erebus-labs/sense_platform/Documents/DIAGRAMS/stacking i2c image.jpg

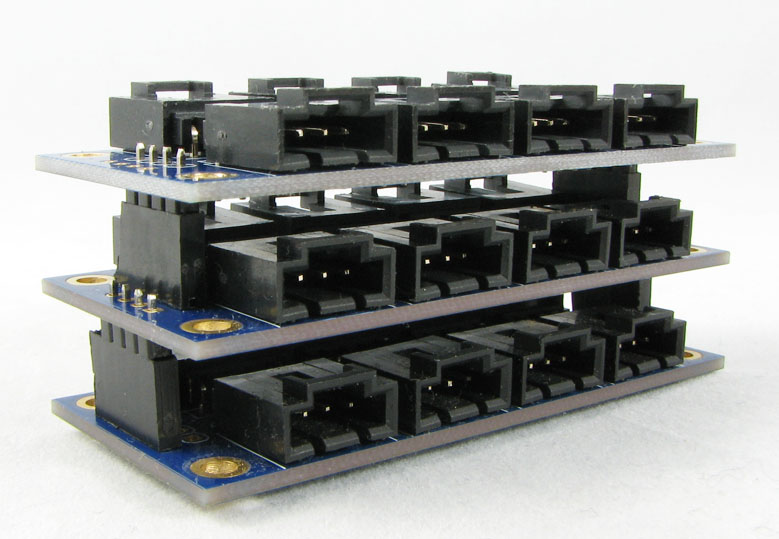
Documents/DIAGRAMS/stacking i2c image.jpg
