erebus-labs/sense_platform/Documents/Requirements Specification.docx

Electrical and Computer Engineering Capstone Requirements/Specifications

Version 1.1

2/22/2015

Erebus Labs

Open Sensor Platform

Submitted By:

Colten Nye

Steve Peirce

Golriz Sedaghat

Supervisor:

Dr. Lisa Zurk

Sponsors:

Dr. Mike Borowczak

Dr. Andrea Burrows

Table of Contents

Introduction

Our goal is to develop and prototype an inexpensive and accessible solution to collect data points of one or more sense-able physical attributes over an arbitrary duration of time. For more information, please refer to the project proposal document.

Requirements

# 1. Function

## 1.1. Configuration

### 1.1.1. Must: Be able to configure device operating parameters…

#### 1.1.1.1. Must: … using low level capabilities (e.g. write a script).

#### 1.1.1.2. Should: … using mid-level capabilities (e.g. using command line functions).

#### 1.1.1.3. May: … using high level capabilities (e.g. using a GUI).

### 1.1.2. Should: Be able to reconfigure parameters in the field (e.g. using a portable computer with USB port.

### 1.1.3. Parameters that may be configured:

#### 1.1.3.1. For each sensor:

#### 1.1.3.1.1. Must: Polling frequency for each sensor.

#### 1.1.3.1.2. Must: Interrupt condition (to take a measurement) for each sensor.

#### 1.1.3.1.3. Should: Out-of-range threshold(s) for each sensor.

#### 1.1.3.2. For the system:

#### 1.1.3.2.1. Should: Low power indicator threshold.

#### 1.1.3.2.2. Should: Low storage indicator threshold.

#### 1.1.3.2.3. Should: Continuous recording Vs. End when out of memory. (keep latest data vs. keep first data)

#### 1.1.3.2.4. May: Conditional data logging, e.g.:

##### 1.1.3.2.4.1. Only log within a time window.

##### 1.1.3.2.4.1.1. Only log within repeating time windows.

##### 1.1.3.2.4.2. Log conditional on a sensor value.

##### 1.1.3.2.4.3. Log conditional on the power level.

## 1.2. Feedback

### 1.2.1. Device must be able to give feedback for certain conditions:

#### 1.2.1.1. Must: Sensor read error.

#### 1.2.1.2. Must: IO busy/idle (do not remove storage device).

#### 1.2.1.3. Should: Low power.

#### 1.2.1.4. Should: Low storage.

#### 1.2.1.5. Should: Sensor value out of threshold.

## 1.3. Data Collection

### 1.3.1. Must: Be able to collect values from sensors designed for this system.

### 1.3.2. Max number of attached sensors supported:

#### 1.3.2.1. Must: 4 sensors.

#### 1.3.2.2. Should: 8 sensors.

#### 1.3.2.3. May: 16 sensors.

### 1.3.3. Max number of stored sample values:

#### 1.3.3.1. Must: 10 million samples.

#### 1.3.3.2. Should: 100 million samples.

#### 1.3.3.3. May: 1 billion samples.

### 1.3.4. Maximum sampling rate:

#### 1.3.4.1. Must: 100 samples / second.

#### 1.3.4.2. Should: 1000 samples / second.

#### 1.3.4.3. May: 10000 samples / second.

## 1.4. Data Retrieval

### 1.4.1. Must: Be able to retrieve recorded data from the device.

### 1.4.2. Should: Retrieve data without interrupting service (e.g. swap out SD cards).

### 1.4.3. May: Be able to retrieve data without physical access to device (e.g. wireless retrieval; See note 1).

## 1.5. Data Analysis

### 1.5.1. Should: Translate retrieved values into values meaningful to the user.

### 1.5.2. Should: Provide a simple tutorial on graphing the data in a spreadsheet.

# 2. Power

## 2.1. Must: Be able to be powered by an external power source without risking damage to the device with reasonable excess voltage.

## 2.2. Must: Handle low voltage/current supply conditions without losing data or adversely affecting the firmware.

## 2.3. Should: Achieve power efficiencies suitable to run the device for extended periods of time on a reasonably sized battery pack (See note 2).

# 3. Unit cost (See note 3)

## 3.1. Must: < $50 per unit.

## 3.2. Should: < $30 per unit.

## 3.3. May: < $15 per unit.

# 4. Misc.

## 4.1. Open Source

### 4.1.1. Must: Implement open source hardware, firmware, and software.

## 4.2. Post-design availability

### 4.2.1. Must: Provide prototype units for each team member and each sponsor (5).

### 4.2.2. Should: Must +5 extras (10).

### 4.2.3. May: Must +10 extras (15).

## 4.3. Community Outreach

### 4.3.1. Should: Apply partnership building with a local K-12 school; Flexible options include teacher conversations, lesson development, and/or helping with a lesson stemming from this research.

Notes

Note 1: It is highly unlikely we will get around to wireless data retrieval by June, however we can leave the infrastructure in place to implement this feature later.

Note 2: Since we have decided to power the device externally, in order to set any duty cycle requirements, we would need to base it on using specified power source. A 3200mAh battery seems reasonable, but we need more information and research to come up with even a ballpark estimate of a duty cycle. We don't feel this should warrant obstructing progress at this point. Basically, if it doesn't last long enough in the field, we just get a bigger battery.

Note 3: A unit is being defined as the cost of the main device and configuration software to the end consumer, without sensors or accessories.

Revision History

Version | Date | Author | Comment
1.0 | 2/22/2015 | Colten Nye | Initial creation
1.1 | 6/7/2015 | Golriz Sedaghat | Modifying the formatting

5 | Page Portland State University ECE Capstone 2015

Open Sensor Platform Requirements/Specifications
