erebus-labs/sense_platform/Documents/WPR/received/Colten 4-10 WPR.odt

# Sensor Platform

# PSU Capstone Project

# WPR

Last Week: 4/4 - 4/10

Next Week: 4/11 - 4/17

# Colten Nye

## Last week:

- Built one main board
  - cut solder mask
  - wiped solder
  - placed components
  - reflowed board
- Made adjustments to GUI
  - Sensor Options windows shows alone
  - Since only one I2C port, removed address field and now Port field dynamically changes between Port and Address depending on sensor type
  - Separate panels for Device configurations and sensor list
- Laid out framework for algorithm to execute I2C sequences.

## Next week:

- Get schedule updated and confirmed with all team members.
- Get full bidirectional serial functionality with a logging window.
- Complete configuration save to / load from local disk.
- Define the sensor definition file elements/syntax/format.

## Issues:

- Running into a variety of issues after I tried to create a git branch. Now git is failing to revert back to a commit that has the correct version of the code due to merging conflicts. I need to do some intensive studying on how git works to rectify this problem and avoid such problems in the future.
