erebus-labs/sense_platform/Documents/WPR/Templates/Full (with Colten) WPR Template.odt

# Sensor Platform

# PSU Capstone Project

# WPR

Last Week: 4/ - 4/

Next Week: 4/ - 4/

# Colten Nye

## Last week:

## Next week:

## Issues:
