erebus-labs/sense_platform/Documents/WPR/WPR2.docx

Sensor Platform Project

Weekly Progress Report 2

Team Members: Colten Nye, Steve Pierce, Golriz Sedaghat

Last Week (1/12/2015 – 1/18/2015)

- High level project description
- Task lists
- Project proposal first draft
- Getting project space FAB-84 on the campus

Next Week (1/19/2015 – 1/25/2015)

- Revising project proposal
- Reviewing the high level design/concepts evaluation
- Functional decomposition of the project
- Meet with our advisor

Issues

None
