erebus-labs/sense_platform/Documents/UI Mockup.pdf

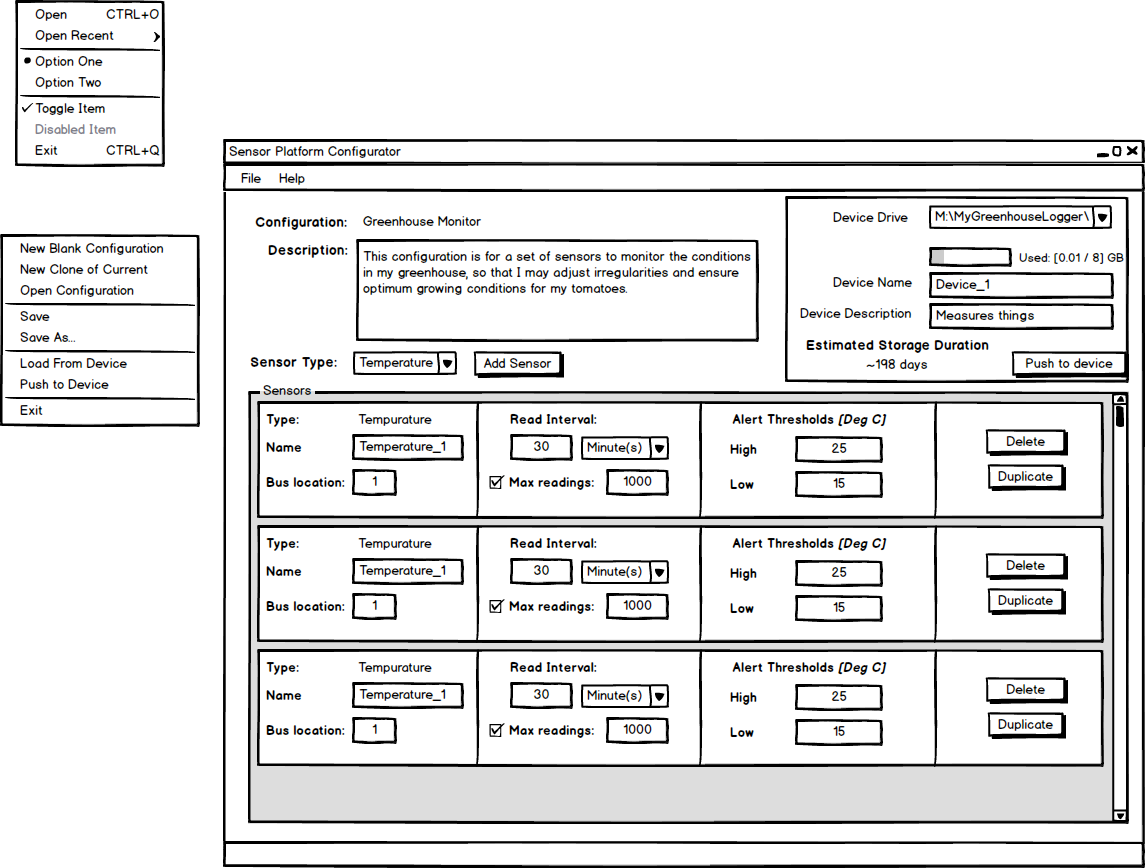
[picture p16: page 1]
