erebus-labs/sense_platform/Documents/DIAGRAMS/Programmer_State_Diagram.pdf

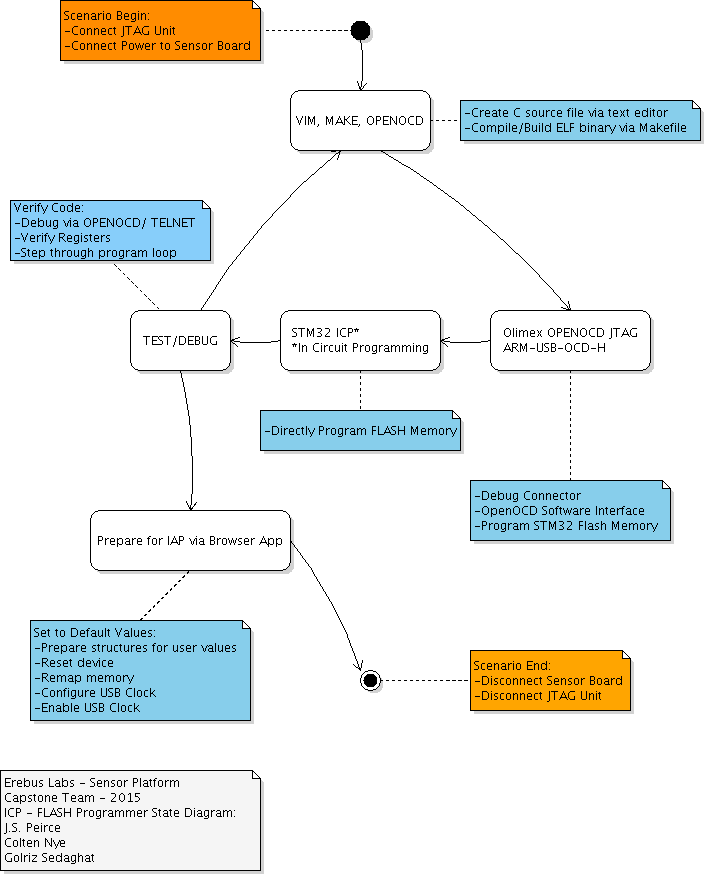
[picture p17: page 1]
