erebus-labs/sense_platform/Documents/DIAGRAMS/User_State_Diagram.pdf

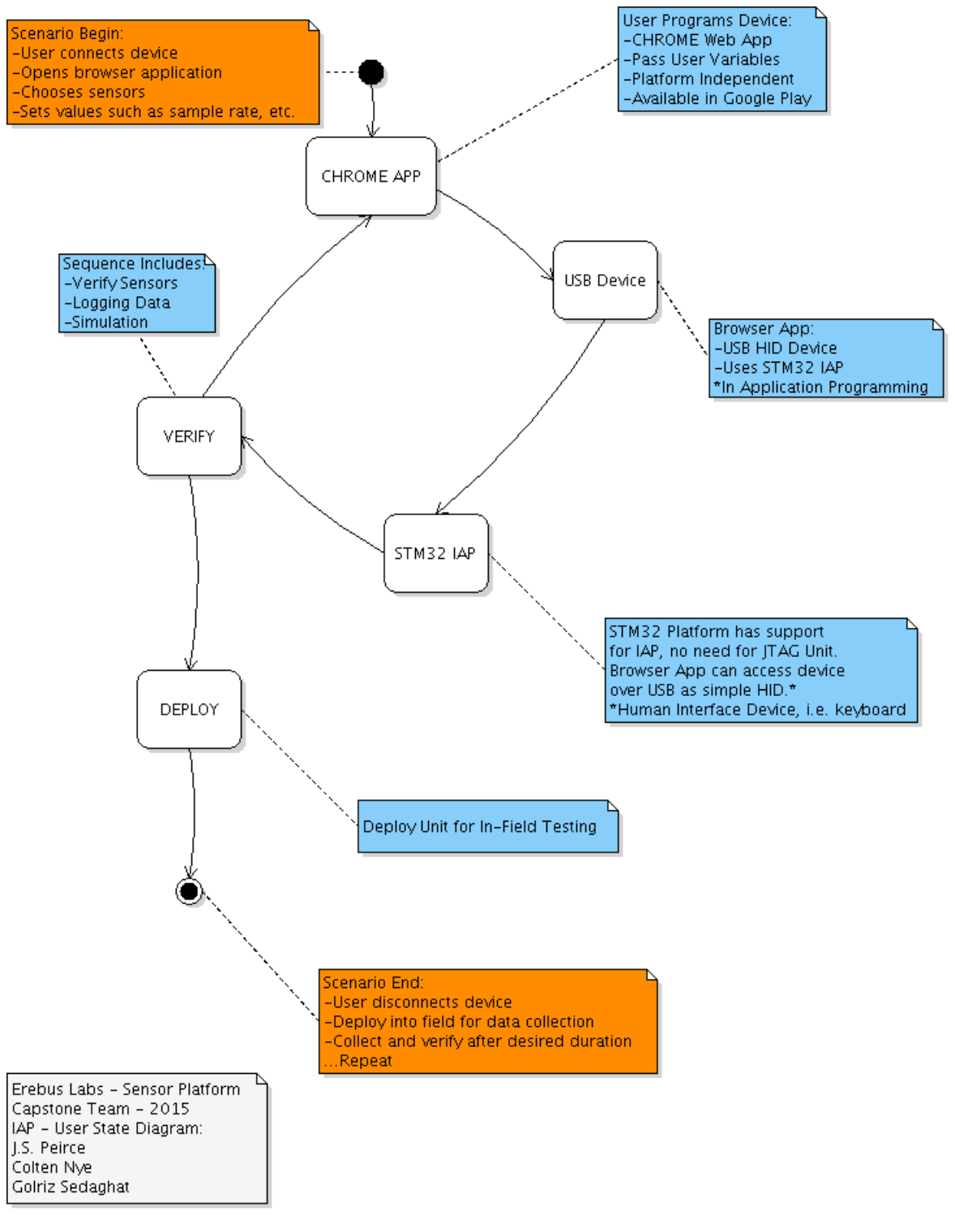
[picture p18: page 1]
