erebus-labs/sense_platform/Documents/DIAGRAMS/UI mockup.PNG

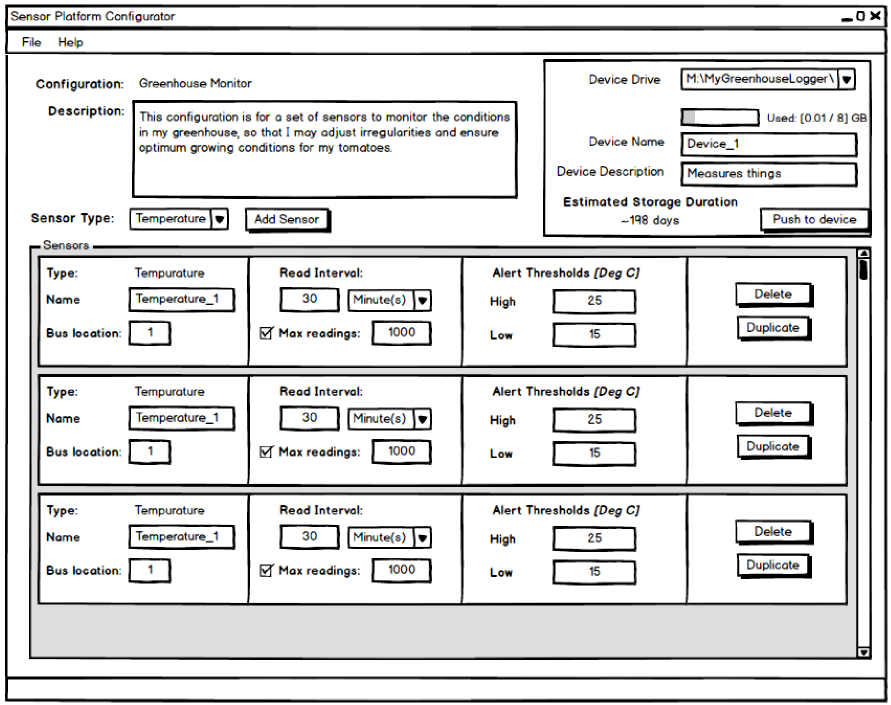
Documents/DIAGRAMS/UI mockup.PNG
