erebus-labs/sense_platform/Documents/BOM.xlsx

Part # | Part Name | Manufacturer | Vendor | Description | Qty | Picture | Unit Cost | 10 | Total Cost For 10 | 100 | Total Cost For 100 | 1000 | Total Cost For 1000
STM32F205RCT6 | MCU | STMicroelectronics | Mouser | ARM Microcontrollers - MCU 32BIT ARM Cortex M3 Connectivity 256kB | 1 | http://www.mouser.com/ProductDetail/STMicroelectronics/STM32F205RCT6/?qs=ZjM2s42DDybn8Yo52JiGMw%3D%3D | $9.01 | $8.12 | $81.20 | $6.66 | $666.00 | $4.86 | $4860.00
ZX62R-B-5P | Micro USB, type B, male | Hirose Connector (http://www.mouser.com/hiroseconnector/) | Mouser | USB Connectors MICRO B RECEPT RA SMT TOP MNT | 2 | http://www.mouser.com/ProductDetail/Hirose-Connector/ZX62R-B-5P/?qs=XQjbzJWzFPUqfCc9Mb2Taw%3D%3D | $1.27 | $1.01 | $20.20 | $0.97 | $193.60 | $0.70 | $1408.00
406C35E16M00000 | 16meg Oscillator | CTS Electronic Components | Mouser | Crystals 16MHz 20pF 30ppm -20C +70C | 1 | http://www.mouser.com/ProductDetail/CTS-Electronic-Components/406C35E16M00000/ | $1.08 | $0.90 | $9.04 | $0.80 | $80.00 | $0.60 | $600.00
STMPS2141STR | Current Limiter | STMicroelectronics | Mouser | Power Switch ICs - Power Distribution SGL CHNL PWR SWTCH | 1 | http://www.mouser.com/ProductDetail/STMicroelectronics/STMPS2141STR/ | $0.97 | $0.75 | $7.49 | $0.48 | $48.40 | $0.39 | $387.00
RCLAMP0504SCT-ND | USB TVS Array | Semtech Corporation (http://digikey.com/Suppliers/us/Semtech.page?lang=en) | DigiKey | TVS DIODE 5VWM 25VC SOT23-6 | 1 | http://www.digikey.com/product-detail/en/RCLAMP0504S.TCT/RCLAMP0504SCT-ND/1000961 | $0.91 | $0.80 | $8.04 | $0.63 | $63.49 | $0.39 | $390.51
TPS73233DBVR | 3.3V Voltage Regulator | Texas Instrument | Mouser | LDO Voltage Regulators Cap-Free NMOS 250mA | 1 | http://www.mouser.com/ProductDetail/Texas-Instruments/TPS73233DBVR/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 | $1.46 | $1.29 | $12.90 | $1.02 | $102.00 | $0.51 | $506.00
PRT-00127 | Micro SD Socket | SparkFun | SparkFun | microSD Socket for Transflash | 1 | https://www.sparkfun.com/products/127 | $3.95 | $3.95 | $39.50 | $3.56 | $356.00 | $3.56 | $3560.00
HSMS-2824-BLKG | Schottky diode | Avago Technologies | Mouser | Schottky Diodes & Rectifiers 15 VBR 1 pF | 1 | http://www.mouser.com/ProductDetail/Avago-Technologies/HSMS-2824-BLKG/?qs=RQ9zk%252b50r5G%2FCiprdMSFQw%3D%3D | $0.89 | $0.72 | $7.19 | $0.55 | $55.30 | $0.39 | $385.00
P4SMA7.5CA-E3/5A** | TVS Diodes | Vishay Semiconductors (http://www.mouser.com/vishaysemiconductors/) | Mouser | TVS Diodes - Transient Voltage Suppressors 400W 7.5V Bidirect | 13 | http://www.mouser.com/ProductDetail/Vishay-Semiconductors/P4SMA75CA-E3-5A/ | $0.22 | $0.35 | $45.63 | $0.22 | $283.40 | $0.15 | $1911.00
NDS352AP | P-Channel MOSFET | Fairchild Semiconductor (http://digikey.com/Suppliers/us/Fairchild-Semiconductor.page?lang=en) | DigiKey | MOSFET P-CH 30V 900MA SSOT3 | 1 | http://www.digikey.com/product-search/en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 | $0.60 | $0.47 | $4.69 | $0.32 | $32.24 | $0.17 | $165.21
DSK-3R3H703T414-HRL | Supercapacitor | Elna America (http://digikey.com/Suppliers/us/Elna-America.page?lang=en) | DigiKey | CAP 70mF -20% +80% 3.3V SMD | 1 | http://www.digikey.com/product-detail/en/DSK-3R3H703T414-HRL/604-1148-2-ND/2171199 | $0.75 | $1.90 | $18.96 | $1.67 | $167.28 | $0.75 | $752.76
AYZ0202AGRLC | Sliding Switch | C&K Components (http://digikey.com/Suppliers/us/C-and-K-Components.page?lang=en) | DigiKey | SWITCH SLIDE DPDT 100MA 12V | 1 | http://www.digikey.com/product-search/en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 | $1.33 | $1.27 | $12.72 | $1.06 | $106.04 | $0.85 | $848.32
COM-00097 | Mini Push Button | SparkFun | SparkFun | Mini Push Button | 4 | https://www.sparkfun.com/products/8720 | $0.95 | $0.95 | $38.00 | $0.86 | $344.00 | $0.86 | $3440.00
APT2012LVBC/D | Blue LED | Kingbright | DigiKey | LED 2.0X1.2MM BLUE SMD | 1 | http://www.digikey.com/product-detail/en/0/754-1938-1-ND | $0.51 | $0.61 | $6.15 | $0.44 | $44.33 | $0.34 | $336.06
SML-M13UTT86 | Red LED | Rohm Semiconductor | DigiKey | LED COMPACT REFL RED 620NM 0805 | 2 | http://www.digikey.com/product-detail/en/0/846-1030-1-ND | $0.34 | $0.41 | $8.26 | $0.27 | $53.56 | $0.15 | $306.00
SML-M13PTT86 | Green LED | Rohm Semiconductor | DigiKey | LED COMPACT REFL GRN 560NM 0805 | 2 | http://www.digikey.com/product-detail/en/0/846-1029-1-ND | $0.40 | $0.50 | $9.92 | $0.32 | $64.26 | $0.18 | $367.20
FT230XS-R | USB to UART | FTDI | DigiKey | IC USB SERIAL BASIC UART 16SSOP | 1 | http://www.digikey.com/product-detail/en/0/768-1135-1-ND | $2.04 | $2.04 | $20.40 | $1.90 | $190.00 | $1.49 | $1487.50
JTAG-CortexM3 | SWD HEADER | FCI | DigiKey | CONN HEADER 10POS DUAL SHRD SMD | 1 | http://www.digikey.com/product-detail/en/20021221-00010C4LF/609-3700-1-ND/2209154 | $0.45 | $0.70 | $7.00 | $0.60 | $60.50 | $0.40 | $400.00
PCB | N/A | OSH Park | N/A | PCB | 5 |  | $23.6 |  | $283.20 |  | $2407.20 |  | $23647.20
Total |  |  |  |  |  |  | $50.74 |  | $640.49 |  | $5317.60 |  | $45757.76
TGS2602* | VOC Sensor | China(Mainland) | AliExpress | VOC sensor for air-quality monitor | 5 | http://www.aliexpress.com/item/5pcs-lot-FIGARO-air-quality-VOC-gas-sensor-TGS2602/1956331481.html | $5.95
TC33X-2-104E | Potentiometer | Bourns Inc. | DigiKey | TRIMMER 100K OHM 0.1W SMD | 5 | http://www.digikey.com/product-detail/en/TC33X-2-104E/TC33X-104ECT-ND/612912 | $0.27
ADXL345BCCZ-RL7 | Accelerometer | Analog Devices Inc (http://digikey.com/Suppliers/us/Analog-Devices.page?lang=en) | DigiKey | IC ACCEL SPI/I2C 3AX 14LGA | 5 | http://www.digikey.com/product-detail/en/ADXL345BCCZ-RL7/ADXL345BCCZ-RL7CT-ND/2038984 | $7.55
