erebus-labs/sense_platform/Documents/Test Plan.xlsx

Sheet: Test Plan V.1.0
 | Sense Platform
 | Test Plan
By: | Colten Nye, Steve Peirce, Golriz Sedaghat
For: | Dr. Mike Borowczak, Dr. Andrea Burrows
Supervisor: | Dr. Lisa Zurk
Introduction: | The test plan defines tests that will be conducted to verify that satisfaction of project requirements. Our goal is to verify the satisfaction of every requirement marked as "must" in the Requirements Specification Document whose satisfaction is not obvious upon inspection. During development, as we become confident of which non-must requirements we will be satisfying, we will update this document to reflect test cases for said requirements.
Test Name: | Sampling Rate
Requirement ID: | 1.1.3.1.1 + 1.3.4.1/2/3
Procedure: | Set a sensor to poll at 100/1000/10000 samples-per-second. Begin logging for some arbitrary amount of time. Using the timestamps on the records, calculate actual samples-per-second.
Pass Criteria: | The sampling rate is within 0.5% of expected.
Test Name: | Interrupt logging
Requirement ID: | 1.1.3.1.2
Procedure: | Set a sensor to trigger a measurement on some well defined condition. Begin logging. Enact the triggering condition.
Pass Criteria: | The condition triggers a measurement.
Test Name: | Sensor read error
Requirement ID: | 1.2.1.1
Procedure: | There are many ways for a sensor read to fail. As we progress in the development process, we will have a more clear idea of all the ways it could fail. For now, we will provide a rudimentary list: - Sensor is disconnected - Unexpected sensor type - Multiple devices responding to TWI address - Storage device is missing / corrupted - ... The general procedure to test this is to create the described scenario.
Pass Criteria: | The feedback indicator indicates an error, and in most cases, the error is entered in the runtime log.
Test Name: | IO busy/ready
Requirement ID: | 1.2.1.2
Procedure: | Configure the device to be logging at a high rate (IO is constantly busy) and begin logging. Indicate an eject request. If indicated, remove storage device.
Pass Criteria: | Device indicates that the storage device is ready to be removed, and recorded data is intact after removal.
Test Name: | Sensor count
Requirement ID: | 1.3.2.1/2/3
Procedure: | Configure the device with 4/8/16 sensors all polling at the maximum designed rate. Begin logging for some arbitrarily short amount of time.
Pass Criteria: | All sensors successfully collected and recorded values at the full polling rate for the full service time.
Test Name: | Max records
Requirement ID: | 1.3.3.1/2/3
Procedure: | Configure the device with any sensor(s) at any polling rate (preferably as high as possible). Begin logging until there should be at least 10/100/1000 million records.
Pass Criteria: | There are at least 10/100/1000 million valid records.
Test Name: | Max frequency
Requirement ID: | 1.3.3.1/2/3
Procedure: | Configure the device with any sensor(s) at any polling rate (preferably as high as possible). Begin logging until there should be at least 10/100/1000 million records.
Pass Criteria: | There are at least 10/100/1000 million valid records.
Test Name: | Over Voltage
Requirement ID: | 2.1
Procedure: | Configure the device with any sensor(s) polling at a reasonably high rate. Power the device using an adjustable voltage source initially set to the device's ideal supply voltage. Set the current limit just before the maximum current handling of the device, as determined by designers. Slowly increase the voltage to 150% of the ideal supply voltage.
Pass Criteria: | The device remains functional and does not trigger the supply's current limiter.
Test Name: | Under Voltage
Requirement ID: | 2.2
Procedure: | Configure the device with any sensor(s) polling at a reasonably high rate. Power the device using an adjustable voltage source initially set to the device's ideal supply voltage. Set the current limit just before the maximum current handling of the device, as determined by designers. Slowly decrease the voltage to 0V.
Pass Criteria: | The device retains all measurements taken with ample power supply, and the device functions correctly upon resuming ample power supply.

Sheet: Test Plan V.2.0
Table of test cases
No. | Test Name | Test Description | Test ID
1 | Main Board Unit Test | Verifies the basic functionality of the main board | MBUT-01
2 | Sensor Boards Unit Test | Verifies the basic functionality of the sensor boards | SBUT-01
3 | Main board and accelerometer integration test | Verifies the interface between the main board and the accelerometer | MAIT-01
4 | Main board and VOC board integration test | Verifies the interface between the main board and the VOC sensor board | MVIT-01
5 | Sampling Rate Test | Verifies the sampling rate at which data from sensors is being stored on the SD Card | SRT-01
6 | Interrupt Logging Test | Verifies if triggering a measurement would interrupt data logging process. | ILT-01
7 | Sensor Read Error Test | Verifies if triggering a measurement would interrupt data logging process. | SRET-01
8 | IO busy/ready | Verifies if the system responds correctly to an eject request. | IOBR-01
9 | Sensor count Test | Verifies the system performance at maximum polling frequency. | SCT-01
10 | Maximum Records Test | Verifies if the device stores valid maximum of data. | MRT-01
11 | Over Voltage Test | Verifies device's performance under over voltage condition. | OVT-01
12 | Under Voltage Test | Verifies device's performance during under voltage condition. | UVT-01
13 | Max Frequency Test | Verifies if the device stores valid data at maximum frequency. | MFT-01
14 | Sensor and Power Removal Test | Verifies device's performance after sensor or power removal while the system is running | SPRT-01
Test Writer: Golriz Sedaghat |  |  |  |  |  |  | Test Writer: Golriz Sedaghat
Test Case Name: |  | Main Board Unit Test | Test ID: |  | MBUT-01 |  | Test Case Name: |  | Sensor Boards Unit Test | Test ID: |  | SBUT-01
Description: |  | Verifies the basic functionality of the main board | Type: |  | White Black X |  | Description: |  | Verifies the basic functionality of the sensor boards | Type: |  | White Black X
Tester Information |  |  |  |  |  |  | Tester Information
Name of Tester: |  |  | Date: |  |  |  | Name of Tester: |  |  | Date:
Hardware Version |  |  | Time: |  |  |  | Hardware Version |  |  | Time:
Setup: |  | Main board, adjustable power supply, digital multi-meter, probes, microscope |  |  |  |  | Setup: |  | VOC and accelerometer sensor boards, adjustable power supply, digital multi-meter, probes, microscope, Arduino board
Step | Action | Expected Result | Pass | Fail | N/A | Comments | Step | Action | Expected Result | Pass | Fail | N/A | Comments
1 | Visually inspect the board | Vias, pads, component footprints, and routings looks right and similar to EAGLE PCB layout |  |  |  |  | 1 | Visually inspect the board | Vias, pads, component footprints, and routings looks right and similar to EAGLE PCB layout
2 | Verify connections after soldering under microscope | No short paths, no disconnected or lose connection |  |  |  |  | 2 | Verify connections before and after soldering | No short paths, no disconnected or lose connection
3 | Verify power levels at test points | 3.3V operating voltage |  |  |  |  | 3 | Verify power levels at test points | Operating voltage for: accelerometer = 3.3V VOC board = 5V
4 | Verify clock signal presence | 16MHz clock frequency |  |  |  |  | 4 | Verify clock signal presence
5 | Verify clock signal frequency | 16MHz clock frequency |  |  |  |  | 5 | Verify clock signal frequency
6 | Write and upload a "Hello World!"/Blinking LED program to test the basic functionality of the board | Expect to see the target LED blinking |  |  |  |  | 6 | Connect the sensor boards to a “known good” device such as Arduino, and verify readings, etc. | Expect valid data
Overall test result: |  |  |  |  |  |  | Overall test result:
Test Writer: Golriz Sedaghat |  |  |  |  |  |  | Test Writer: Golriz Sedaghat
Test Case Name: |  | Main board and accelerometer integration test | Test ID: |  | MAIT-01 |  | Test Case Name: |  | Main board and VOC board integration test | Test ID: |  | MVIT-01
Description: |  | Verifies the interface between the main board and the accelerometer | Type: |  | White Black X |  | Description: |  | Verifies the interface between the main board and the VOC sensor board | Type: |  | White Black X
Tester Information |  |  |  |  |  |  | Tester Information
Name of Tester: |  |  | Date: |  |  |  | Name of Tester: |  |  | Date:
Hardware Version |  |  | Time: |  |  |  | Hardware Version |  |  | Time:
Setup: |  | Accelerometer sensor board, main board, web application GUI installed on the computer system |  |  |  |  | Setup: |  | VOC sensor board, main board, web application GUI installed on the computer system
Step | Action | Expected Result | Pass | Fail | N/A | Comments | Step | Action | Expected Result | Pass | Fail | N/A | Comments
1 | Power up the main board | The recorded data should be similar to collected data by Arduino |  |  |  |  | 1 | Power up the main board | The recorded data should be as valid as collected data by Arduino
2 | Connect the accelerometer to I2C header on the main board |  |  |  |  |  | 2 | Connect the VOC to one of the analog headers on the main board
3 | Configure the I2C sensor at a valid sampling rate in the GUI |  |  |  |  |  | 3 | Configure the analog sensor at a valid sampling rate in the GUI
4 | Begin logging data |  |  |  |  |  | 4 | Begin logging data
5 | Verify the recorded data against "known good" values collected by an Arduino board |  |  |  |  |  | 5 | Verify the recorded data against "known good" values collected by Arduino board
Overall test result: |  |  |  |  |  |  | Overall test result:
Test Writer: Colten Nye |  |  |  |  |  |  | Test Writer: Colten Nye
Test Case Name: |  | Sampling Rate Test | Test ID: |  | SRT-01 |  | Test Case Name: |  | Interrupt logging Test | Test ID: |  | ILT-01
Description: |  | Verifies the sampling rate at which data from sensors is being stored on the SD Card | Type: |  | White Black X |  | Description: |  | Verifies if triggering a measurement would interrupt data logging process. | Type: |  | White Black X
Tester Information |  |  |  |  |  |  | Tester Information
Name of Tester: |  |  | Date: |  |  |  | Name of Tester: |  |  | Date:
Hardware Version |  |  | Time: |  |  |  | Hardware Version |  |  | Time:
Setup: |  | An I2C or analog sensor, sensor platform main board, web application GUI installed on the computer system |  |  |  |  | Setup: |  | An I2C or analog sensor, sensor platform main board, web application GUI installed on the computer system
Step | Action | Expected Result | Pass | Fail | N/A | Comments | Step | Action | Expected Result | Pass | Fail | N/A | Comments
1 | Set a sensor to poll at 100/1000/10000 samples-per-second. | The sampling rate is within 0.5% of expected. |  |  |  |  | 1 | Set a sensor to trigger a measurement on some well defined condition. | The condition triggers a measurement.
2 | Begin logging for some arbitrary amount of time. |  |  |  |  |  | 2 | Begin logging data.
3 | Using the timestamps on the records, calculate actual samples-per-second. |  |  |  |  |  | 3 | Enact the triggering condition.
Overall test result: |  |  |  |  |  |  | Overall test result:
Test Writer: Colten Nye |  |  |  |  |  |  | Test Writer: Colten Nye
Test Case Name: |  | Sensor Read Error Test | Test ID: |  | SRET-01 |  | Test Case Name: |  | IO busy/ready | Test ID: |  | IOBR-01
Description: |  | Verifies if triggering a measurement would interrupt data logging process. | Type: |  | White Black X |  | Description: |  | Verifies if the system responds correctly to an eject request. | Type: |  | White Black X
Tester Information |  |  |  |  |  |  | Tester Information
Name of Tester: |  |  | Date: |  |  |  | Name of Tester: |  |  | Date:
Hardware Version |  |  | Time: |  |  |  | Hardware Version |  |  | Time:
Setup: |  | An I2C or analog sensor, sensor platform main board, web application GUI installed on the computer system |  |  |  |  | Setup: |  | An I2C or analog sensor, sensor platform main board, web application GUI installed on the computer system
Step | Action | Expected Result | Pass | Fail | N/A | Comments | Step | Action | Expected Result | Pass | Fail | N/A | Comments
1 | Sensor is disconnected | The feedback indicator indicates an error, and in most cases, the error is entered in the runtime log. |  |  |  |  | 1 | Configure the device to be logging at a high rate (IO is constantly busy) | Device indicates that the storage device is ready to be removed, and recorded data is intact after removal.
2 | Connect an unsupported sensor type |  |  |  |  |  | 2 | Begin logging data
3 | Multiple devices responding to TWI address |  |  |  |  |  | 3 | Indicate an eject request.
4 | Storage device is missing / corrupted |  |  |  |  |  | 4 | If indicated, remove storage device.
5 | Attempt to read from bad I2C addresses |  |  |  |  |  | Overall test result:
Overall test result:
Test Writer: Colten Nye |  |  |  |  |  |  | Test Writer: Colten Nye
Test Case Name: |  | Sensor count Test | Test ID: |  | SCT-01 |  | Test Case Name: |  | Maximum Records Test | Test ID: |  | MRT-01
Description: |  | Verifies the system performance at maximum polling frequency. | Type: |  | White Black X |  | Description: |  | Verifies if the device stores valid maximum of data. | Type: |  | White Black X
Tester Information |  |  |  |  |  |  | Tester Information
Name of Tester: |  |  | Date: |  |  |  | Name of Tester: |  |  | Date:
Hardware Version |  |  | Time: |  |  |  | Hardware Version |  |  | Time:
Setup: |  | An I2C or analog sensor, sensor platform main board, web application GUI installed on the computer system |  |  |  |  | Setup: |  | An I2C or analog sensor, sensor platform main board, web application GUI installed on the computer system
Step | Action | Expected Result | Pass | Fail | N/A | Comments | Step | Action | Expected Result | Pass | Fail | N/A | Comments
1 | Configure the device with 4 sensors | All sensors successfully collected and recorded values at the full polling rate for the full service time. |  |  |  |  | 1 | Configure the device with an I2C or analog sensor(s) at a valid polling rate (preferably as high as possible) | There are at least 10/100/1000 million valid records.
2 | Set the polling rate at maximum for all the sensors |  |  |  |  |  | 2 | Begin logging data until there should be at least 10/100/1000 million records.
3 | Begin logging data for some arbitrarily short amount of time. |  |  |  |  |  | Overall test result:
4 | Repeat the above steps for 8 and 16 I2C sensors
Overall test result:
Test Writer: Colten Nye |  |  |  |  |  |  | Test Writer: Colten Nye
Test Case Name: |  | Over Voltage Test | Test ID: |  | OVT-01 |  | Test Case Name: |  | Under Voltage Test | Test ID: |  | UVT-01
Description: |  | Verifies device's performance under over voltage condition. | Type: |  | White Black X |  | Description: |  | Verifies device's performance during under voltage condition. | Type: |  | White Black X
Tester Information |  |  |  |  |  |  | Tester Information
Name of Tester: |  |  | Date: |  |  |  | Name of Tester: |  |  | Date:
Hardware Version |  |  | Time: |  |  |  | Hardware Version |  |  | Time:
Setup: |  | An I2C or analog sensor, sensor platform main board, web application GUI installed on the computer system, adjustable DC power supply |  |  |  |  | Setup: |  | An I2C or analog sensor, sensor platform main board, web application GUI installed on the computer system, adjustable DC power supply
Step | Action | Expected Result | Pass | Fail | N/A | Comments | Step | Action | Expected Result | Pass | Fail | N/A | Comments
1 | Configure the device with an I2C or analog sensor(s) at a valid polling rate (preferably as high as possible) | The device remains functional and does not trigger the supply's current limiter. |  |  |  |  | 1 | Configure the device with an I2C or analog sensor(s) at a valid polling rate (preferably as high as possible) | The device retains all measurements taken with ample power supply, and the device functions correctly upon resuming ample power supply.
2 | Power the device using an adjustable voltage source initially set to the device's ideal supply voltage (3.3V). |  |  |  |  |  | 2 | Power the device using an adjustable voltage source initially set to the device's ideal supply voltage (3.3V).
3 | Set the current limit just before the maximum current handling of the device, as determined by designers. |  |  |  |  |  | 3 | Set the current limit just before the maximum current handling of the device, as determined by designers.
4 | Slowly increase the voltage to 150% of the ideal supply voltage. |  |  |  |  |  | 4 | Slowly decrease the voltage to 0V.
Overall test result: |  |  |  |  |  |  | Overall test result:
Test Writer: Colten Nye |  |  |  |  |  |  | Test Writer: Golriz Sedaghat
Test Case Name: |  | Max Frequency Test | Test ID: |  | MFT-01 |  | Test Case Name: |  | Sensor and Power Removal Test | Test ID: |  | SPRT-01
Description: |  | Verifies if the device stores valid data at maximum frequency. | Type: |  | White Black X |  | Description: |  | Verifies device's performance after sensor or power removal while the system is running | Type: |  | White Black X
Tester Information |  |  |  |  |  |  | Tester Information
Name of Tester: |  |  | Date: |  |  |  | Name of Tester: |  |  | Date:
Hardware Version |  |  | Time: |  |  |  | Hardware Version |  |  | Time:
Setup: |  | An I2C or analog sensor, sensor platform main board, web application GUI installed on the computer system |  |  |  |  | Setup: |  | An I2C and analog sensor, sensor platform main board, web application GUI installed on the computer system
Step | Action | Expected Result | Pass | Fail | N/A | Comments | Step | Action | Expected Result | Pass | Fail | N/A | Comments
1 | Configure the device with an I2C or analog sensor(s) at a valid polling rate (preferably as high as possible) | There are at least 10/100/1000 million valid records. |  |  |  |  | 1 | Power up the main board
2 | Begin logging data until there should be at least 10/100/1000 million records. |  |  |  |  |  | 2 | Configure the device with I2C sensor at a valid sampling rate
Overall test result: |  |  |  |  |  |  | 3 | Begin logging data
 |  |  |  |  |  |  | 4 | Remove the sensor while it is sampling | Data should be stored up to the time that sensor was connected, without any data loss.
 |  |  |  |  |  |  | 5 | Configure the device with analog sensor at a valid sampling rate
 |  |  |  |  |  |  | 6 | Begin logging data
 |  |  |  |  |  |  | 7 | Remove the sensor while it is sampling | Data should be stored up to the time that sensor was connected, without any data loss.
 |  |  |  |  |  |  | 8 | Configure the device with I2C or analog sensor at a valid sampling rate
 |  |  |  |  |  |  | 9 | Begin logging data
 |  |  |  |  |  |  | 10 | Remove the power which sensor is sampling | Data should be stored up to the time that power was connected, without any data loss.
 |  |  |  |  |  |  | Overall test result:

Sheet: Revision History
Version | Date | Author | Comment
1.0 | 2015-02-22 | Colten Nye | Initial creation
2.0 | 2015-04-17 | Golriz Sedaghat | Modified the structure of the previous version and added more test cases based on the test plan overview written by Steve Peirce
