erebus-labs/sense_platform/CS_TEST_EVAL/MDK-ARM/CS_TEST_EVAL Configuration/CS_TEST_EVAL Configuration.htm

# Static Call Graph for image .\CS_TEST_EVAL Configuration\CS_TEST_EVAL Configuration.axf

#<CALLGRAPH># ARM Linker, 5050106: Last Updated: Fri Feb 27 16:17:08 2015

### Maximum Stack Usage = 688 bytes + Unknown(Cycles, Untraceable Function Pointers)

### Call chain for Maximum Stack Depth:

SD_read ⇒ BSP_SD_ReadBlocks_DMA ⇒ HAL_SD_ReadBlocks_DMA ⇒ HAL_DMA_Start_IT ⇒ DMA_SetConfig

### Mutually Recursive functions

- NMI_Handler ⇒ NMI_Handler
- HardFault_Handler ⇒ HardFault_Handler
- MemManage_Handler ⇒ MemManage_Handler
- BusFault_Handler ⇒ BusFault_Handler
- UsageFault_Handler ⇒ UsageFault_Handler
- SVC_Handler ⇒ SVC_Handler
- DebugMon_Handler ⇒ DebugMon_Handler
- PendSV_Handler ⇒ PendSV_Handler
- ADC_IRQHandler ⇒ ADC_IRQHandler

### Function Pointers

- ADC_IRQHandler from startup_stm32f207xx.o(.text) referenced from startup_stm32f207xx.o(RESET)
- BusFault_Handler from startup_stm32f207xx.o(.text) referenced from startup_stm32f207xx.o(RESET)
- CAN1_RX0_IRQHandler from startup_stm32f207xx.o(.text) referenced from startup_stm32f207xx.o(RESET)
- CAN1_RX1_IRQHandler from startup_stm32f207xx.o(.text) referenced from startup_stm32f207xx.o(RESET)
- CAN1_SCE_IRQHandler from startup_stm32f207xx.o(.text) referenced from startup_stm32f207xx.o(RESET)
- CAN1_TX_IRQHandler from startup_stm32f207xx.o(.text) referenced from startup_stm32f207xx.o(RESET)
- CAN2_RX0_IRQHandler from startup_stm32f207xx.o(.text) referenced from startup_stm32f207xx.o(RESET)
- CAN2_RX1_IRQHandler from startup_stm32f207xx.o(.text) referenced from startup_stm32f207xx.o(RESET)
- CAN2_SCE_IRQHandler from startup_stm32f207xx.o(.text) referenced from startup_stm32f207xx.o(RESET)
- CAN2_TX_IRQHandler from startup_stm32f207xx.o(.text) referenced from startup_stm32f207xx.o(RESET)
- DCMI_IRQHandler from startup_stm32f207xx.o(.text) referenced from startup_stm32f207xx.o(RESET)
- DMA1_Stream0_IRQHandler from startup_stm32f207xx.o(.text) referenced from startup_stm32f207xx.o(RESET)
- DMA1_Stream1_IRQHandler from startup_stm32f207xx.o(.text) referenced from startup_stm32f207xx.o(RESET)
- DMA1_Stream2_IRQHandler from startup_stm32f207xx.o(.text) referenced from startup_stm32f207xx.o(RESET)
- DMA1_Stream3_IRQHandler from startup_stm32f207xx.o(.text) referenced from startup_stm32f207xx.o(RESET)
- DMA1_Stream4_IRQHandler from startup_stm32f207xx.o(.text) referenced from startup_stm32f207xx.o(RESET)
- DMA1_Stream5_IRQHandler from startup_stm32f207xx.o(.text) referenced from startup_stm32f207xx.o(RESET)
- DMA1_Stream6_IRQHandler from startup_stm32f207xx.o(.text) referenced from startup_stm32f207xx.o(RESET)
- DMA1_Stream7_IRQHandler from startup_stm32f207xx.o(.text) referenced from startup_stm32f207xx.o(RESET)
- DMA2_Stream0_IRQHandler from startup_stm32f207xx.o(.text) referenced from startup_stm32f207xx.o(RESET)
- DMA2_Stream1_IRQHandler from startup_stm32f207xx.o(.text) referenced from startup_stm32f207xx.o(RESET)
- DMA2_Stream2_IRQHandler from startup_stm32f207xx.o(.text) referenced from startup_stm32f207xx.o(RESET)
- DMA2_Stream3_IRQHandler from startup_stm32f207xx.o(.text) referenced from startup_stm32f207xx.o(RESET)
- DMA2_Stream4_IRQHandler from startup_stm32f207xx.o(.text) referenced from startup_stm32f207xx.o(RESET)
- DMA2_Stream5_IRQHandler from startup_stm32f207xx.o(.text) referenced from startup_stm32f207xx.o(RESET)
- DMA2_Stream6_IRQHandler from startup_stm32f207xx.o(.text) referenced from startup_stm32f207xx.o(RESET)
- DMA2_Stream7_IRQHandler from startup_stm32f207xx.o(.text) referenced from startup_stm32f207xx.o(RESET)
- DebugMon_Handler from startup_stm32f207xx.o(.text) referenced from startup_stm32f207xx.o(RESET)
- ETH_IRQHandler from startup_stm32f207xx.o(.text) referenced from startup_stm32f207xx.o(RESET)
- ETH_WKUP_IRQHandler from startup_stm32f207xx.o(.text) referenced from startup_stm32f207xx.o(RESET)
- EXTI0_IRQHandler from startup_stm32f207xx.o(.text) referenced from startup_stm32f207xx.o(RESET)
- EXTI15_10_IRQHandler from startup_stm32f207xx.o(.text) referenced from startup_stm32f207xx.o(RESET)
- EXTI1_IRQHandler from startup_stm32f207xx.o(.text) referenced from startup_stm32f207xx.o(RESET)
- EXTI2_IRQHandler from startup_stm32f207xx.o(.text) referenced from startup_stm32f207xx.o(RESET)
- EXTI3_IRQHandler from startup_stm32f207xx.o(.text) referenced from startup_stm32f207xx.o(RESET)
- EXTI4_IRQHandler from startup_stm32f207xx.o(.text) referenced from startup_stm32f207xx.o(RESET)
- EXTI9_5_IRQHandler from startup_stm32f207xx.o(.text) referenced from startup_stm32f207xx.o(RESET)
- FLASH_IRQHandler from startup_stm32f207xx.o(.text) referenced from startup_stm32f207xx.o(RESET)
- FMC_IRQHandler from startup_stm32f207xx.o(.text) referenced from startup_stm32f207xx.o(RESET)
- FPU_IRQHandler from startup_stm32f207xx.o(.text) referenced from startup_stm32f207xx.o(RESET)
- HASH_RNG_IRQHandler from startup_stm32f207xx.o(.text) referenced from startup_stm32f207xx.o(RESET)
- HardFault_Handler from startup_stm32f207xx.o(.text) referenced from startup_stm32f207xx.o(RESET)
- I2C1_ER_IRQHandler from startup_stm32f207xx.o(.text) referenced from startup_stm32f207xx.o(RESET)
- I2C1_EV_IRQHandler from startup_stm32f207xx.o(.text) referenced from startup_stm32f207xx.o(RESET)
- I2C2_ER_IRQHandler from startup_stm32f207xx.o(.text) referenced from startup_stm32f207xx.o(RESET)
- I2C2_EV_IRQHandler from startup_stm32f207xx.o(.text) referenced from startup_stm32f207xx.o(RESET)
- I2C3_ER_IRQHandler from startup_stm32f207xx.o(.text) referenced from startup_stm32f207xx.o(RESET)
- I2C3_EV_IRQHandler from startup_stm32f207xx.o(.text) referenced from startup_stm32f207xx.o(RESET)
- MemManage_Handler from startup_stm32f207xx.o(.text) referenced from startup_stm32f207xx.o(RESET)
- NMI_Handler from startup_stm32f207xx.o(.text) referenced from startup_stm32f207xx.o(RESET)
- OTG_FS_IRQHandler from startup_stm32f207xx.o(.text) referenced from startup_stm32f207xx.o(RESET)
- OTG_FS_WKUP_IRQHandler from startup_stm32f207xx.o(.text) referenced from startup_stm32f207xx.o(RESET)
- OTG_HS_EP1_IN_IRQHandler from startup_stm32f207xx.o(.text) referenced from startup_stm32f207xx.o(RESET)
- OTG_HS_EP1_OUT_IRQHandler from startup_stm32f207xx.o(.text) referenced from startup_stm32f207xx.o(RESET)
- OTG_HS_IRQHandler from startup_stm32f207xx.o(.text) referenced from startup_stm32f207xx.o(RESET)
- OTG_HS_WKUP_IRQHandler from startup_stm32f207xx.o(.text) referenced from startup_stm32f207xx.o(RESET)
- PVD_IRQHandler from startup_stm32f207xx.o(.text) referenced from startup_stm32f207xx.o(RESET)
- PendSV_Handler from startup_stm32f207xx.o(.text) referenced from startup_stm32f207xx.o(RESET)
- RCC_IRQHandler from startup_stm32f207xx.o(.text) referenced from startup_stm32f207xx.o(RESET)
- RTC_Alarm_IRQHandler from stm32f2xx_it.o(i.RTC_Alarm_IRQHandler) referenced from startup_stm32f207xx.o(RESET)
- RTC_WKUP_IRQHandler from startup_stm32f207xx.o(.text) referenced from startup_stm32f207xx.o(RESET)
- Reset_Handler from startup_stm32f207xx.o(.text) referenced from startup_stm32f207xx.o(RESET)
- SDIO_IRQHandler from startup_stm32f207xx.o(.text) referenced from startup_stm32f207xx.o(RESET)
- SD_DMA_RxCplt from stm32f2xx_hal_sd.o(i.SD_DMA_RxCplt) referenced from stm32f2xx_hal_sd.o(i.HAL_SD_ReadBlocks_DMA)
- SD_DMA_RxError from stm32f2xx_hal_sd.o(i.SD_DMA_RxError) referenced from stm32f2xx_hal_sd.o(i.HAL_SD_ReadBlocks_DMA)
- SD_DMA_TxCplt from stm32f2xx_hal_sd.o(i.SD_DMA_TxCplt) referenced from stm32f2xx_hal_sd.o(i.HAL_SD_WriteBlocks_DMA)
- SD_DMA_TxError from stm32f2xx_hal_sd.o(i.SD_DMA_TxError) referenced from stm32f2xx_hal_sd.o(i.HAL_SD_WriteBlocks_DMA)
- SD_initialize from sd_diskio.o(i.SD_initialize) referenced from sd_diskio.o(.data)
- SD_ioctl from sd_diskio.o(i.SD_ioctl) referenced from sd_diskio.o(.data)
- SD_read from sd_diskio.o(i.SD_read) referenced from sd_diskio.o(.data)
- SD_status from sd_diskio.o(i.SD_status) referenced from sd_diskio.o(.data)
- SD_write from sd_diskio.o(i.SD_write) referenced from sd_diskio.o(.data)
- SPI1_IRQHandler from startup_stm32f207xx.o(.text) referenced from startup_stm32f207xx.o(RESET)
- SPI2_IRQHandler from startup_stm32f207xx.o(.text) referenced from startup_stm32f207xx.o(RESET)
- SPI3_IRQHandler from startup_stm32f207xx.o(.text) referenced from startup_stm32f207xx.o(RESET)
- SVC_Handler from startup_stm32f207xx.o(.text) referenced from startup_stm32f207xx.o(RESET)
- SysTick_Handler from stm32f2xx_it.o(i.SysTick_Handler) referenced from startup_stm32f207xx.o(RESET)
- SystemInit from system_stm32f2xx.o(i.SystemInit) referenced from startup_stm32f207xx.o(.text)
- TAMP_STAMP_IRQHandler from startup_stm32f207xx.o(.text) referenced from startup_stm32f207xx.o(RESET)
- TIM1_BRK_TIM9_IRQHandler from startup_stm32f207xx.o(.text) referenced from startup_stm32f207xx.o(RESET)
- TIM1_CC_IRQHandler from startup_stm32f207xx.o(.text) referenced from startup_stm32f207xx.o(RESET)
- TIM1_TRG_COM_TIM11_IRQHandler from startup_stm32f207xx.o(.text) referenced from startup_stm32f207xx.o(RESET)
- TIM1_UP_TIM10_IRQHandler from startup_stm32f207xx.o(.text) referenced from startup_stm32f207xx.o(RESET)
- TIM2_IRQHandler from startup_stm32f207xx.o(.text) referenced from startup_stm32f207xx.o(RESET)
- TIM3_IRQHandler from startup_stm32f207xx.o(.text) referenced from startup_stm32f207xx.o(RESET)
- TIM4_IRQHandler from startup_stm32f207xx.o(.text) referenced from startup_stm32f207xx.o(RESET)
- TIM5_IRQHandler from startup_stm32f207xx.o(.text) referenced from startup_stm32f207xx.o(RESET)
- TIM6_DAC_IRQHandler from startup_stm32f207xx.o(.text) referenced from startup_stm32f207xx.o(RESET)
- TIM7_IRQHandler from startup_stm32f207xx.o(.text) referenced from startup_stm32f207xx.o(RESET)
- TIM8_BRK_TIM12_IRQHandler from startup_stm32f207xx.o(.text) referenced from startup_stm32f207xx.o(RESET)
- TIM8_CC_IRQHandler from startup_stm32f207xx.o(.text) referenced from startup_stm32f207xx.o(RESET)
- TIM8_TRG_COM_TIM14_IRQHandler from startup_stm32f207xx.o(.text) referenced from startup_stm32f207xx.o(RESET)
- TIM8_UP_TIM13_IRQHandler from startup_stm32f207xx.o(.text) referenced from startup_stm32f207xx.o(RESET)
- UART4_IRQHandler from startup_stm32f207xx.o(.text) referenced from startup_stm32f207xx.o(RESET)
- UART5_IRQHandler from startup_stm32f207xx.o(.text) referenced from startup_stm32f207xx.o(RESET)
- USART1_IRQHandler from startup_stm32f207xx.o(.text) referenced from startup_stm32f207xx.o(RESET)
- USART2_IRQHandler from startup_stm32f207xx.o(.text) referenced from startup_stm32f207xx.o(RESET)
- USART3_IRQHandler from startup_stm32f207xx.o(.text) referenced from startup_stm32f207xx.o(RESET)
- USART6_IRQHandler from startup_stm32f207xx.o(.text) referenced from startup_stm32f207xx.o(RESET)
- UsageFault_Handler from startup_stm32f207xx.o(.text) referenced from startup_stm32f207xx.o(RESET)
- WWDG_IRQHandler from startup_stm32f207xx.o(.text) referenced from startup_stm32f207xx.o(RESET)
- __main from entry.o(.ARM.Collect$$$$00000000) referenced from startup_stm32f207xx.o(.text)
- main from main.o(i.main) referenced from entry9a.o(.ARM.Collect$$$$0000000B)

### Global Symbols

__main (Thumb, 0 bytes, Stack size unknown bytes, entry.o(.ARM.Collect$$$$00000000))
[Address Reference Count : 1]

- startup_stm32f207xx.o(.text)

_main_stk (Thumb, 0 bytes, Stack size unknown bytes, entry2.o(.ARM.Collect$$$$00000001))

_main_scatterload (Thumb, 0 bytes, Stack size unknown bytes, entry5.o(.ARM.Collect$$$$00000004))

[Calls]

- >> __scatterload

__main_after_scatterload (Thumb, 0 bytes, Stack size unknown bytes, entry5.o(.ARM.Collect$$$$00000004))

[Called By]

- >> __scatterload

_main_clock (Thumb, 0 bytes, Stack size unknown bytes, entry7b.o(.ARM.Collect$$$$00000008))

_main_cpp_init (Thumb, 0 bytes, Stack size unknown bytes, entry8b.o(.ARM.Collect$$$$0000000A))

_main_init (Thumb, 0 bytes, Stack size unknown bytes, entry9a.o(.ARM.Collect$$$$0000000B))

__rt_final_cpp (Thumb, 0 bytes, Stack size unknown bytes, entry10a.o(.ARM.Collect$$$$0000000D))

__rt_final_exit (Thumb, 0 bytes, Stack size unknown bytes, entry11a.o(.ARM.Collect$$$$0000000F))

Reset_Handler (Thumb, 8 bytes, Stack size 0 bytes, startup_stm32f207xx.o(.text))
[Address Reference Count : 1]

- startup_stm32f207xx.o(RESET)

NMI_Handler (Thumb, 2 bytes, Stack size 0 bytes, startup_stm32f207xx.o(.text))

[Calls]

- >> NMI_Handler

[Called By]

- >> NMI_Handler

[Address Reference Count : 1]

- startup_stm32f207xx.o(RESET)

HardFault_Handler (Thumb, 2 bytes, Stack size 0 bytes, startup_stm32f207xx.o(.text))

[Calls]

- >> HardFault_Handler

[Called By]

- >> HardFault_Handler

[Address Reference Count : 1]

- startup_stm32f207xx.o(RESET)

MemManage_Handler (Thumb, 2 bytes, Stack size 0 bytes, startup_stm32f207xx.o(.text))

[Calls]

- >> MemManage_Handler

[Called By]

- >> MemManage_Handler

[Address Reference Count : 1]

- startup_stm32f207xx.o(RESET)

BusFault_Handler (Thumb, 2 bytes, Stack size 0 bytes, startup_stm32f207xx.o(.text))

[Calls]

- >> BusFault_Handler

[Called By]

- >> BusFault_Handler

[Address Reference Count : 1]

- startup_stm32f207xx.o(RESET)

UsageFault_Handler (Thumb, 2 bytes, Stack size 0 bytes, startup_stm32f207xx.o(.text))

[Calls]

- >> UsageFault_Handler

[Called By]

- >> UsageFault_Handler

[Address Reference Count : 1]

- startup_stm32f207xx.o(RESET)

SVC_Handler (Thumb, 2 bytes, Stack size 0 bytes, startup_stm32f207xx.o(.text))

[Calls]

- >> SVC_Handler

[Called By]

- >> SVC_Handler

[Address Reference Count : 1]

- startup_stm32f207xx.o(RESET)

DebugMon_Handler (Thumb, 2 bytes, Stack size 0 bytes, startup_stm32f207xx.o(.text))

[Calls]

- >> DebugMon_Handler

[Called By]

- >> DebugMon_Handler

[Address Reference Count : 1]

- startup_stm32f207xx.o(RESET)

PendSV_Handler (Thumb, 2 bytes, Stack size 0 bytes, startup_stm32f207xx.o(.text))

[Calls]

- >> PendSV_Handler

[Called By]

- >> PendSV_Handler

[Address Reference Count : 1]

- startup_stm32f207xx.o(RESET)

ADC_IRQHandler (Thumb, 0 bytes, Stack size 0 bytes, startup_stm32f207xx.o(.text))

[Calls]

- >> ADC_IRQHandler

[Called By]

- >> ADC_IRQHandler

[Address Reference Count : 1]

- startup_stm32f207xx.o(RESET)

CAN1_RX0_IRQHandler (Thumb, 0 bytes, Stack size 0 bytes, startup_stm32f207xx.o(.text))
[Address Reference Count : 1]

- startup_stm32f207xx.o(RESET)

CAN1_RX1_IRQHandler (Thumb, 0 bytes, Stack size 0 bytes, startup_stm32f207xx.o(.text))
[Address Reference Count : 1]

- startup_stm32f207xx.o(RESET)

CAN1_SCE_IRQHandler (Thumb, 0 bytes, Stack size 0 bytes, startup_stm32f207xx.o(.text))
[Address Reference Count : 1]

- startup_stm32f207xx.o(RESET)

CAN1_TX_IRQHandler (Thumb, 0 bytes, Stack size 0 bytes, startup_stm32f207xx.o(.text))
[Address Reference Count : 1]

- startup_stm32f207xx.o(RESET)

CAN2_RX0_IRQHandler (Thumb, 0 bytes, Stack size 0 bytes, startup_stm32f207xx.o(.text))
[Address Reference Count : 1]

- startup_stm32f207xx.o(RESET)

CAN2_RX1_IRQHandler (Thumb, 0 bytes, Stack size 0 bytes, startup_stm32f207xx.o(.text))
[Address Reference Count : 1]

- startup_stm32f207xx.o(RESET)

CAN2_SCE_IRQHandler (Thumb, 0 bytes, Stack size 0 bytes, startup_stm32f207xx.o(.text))
[Address Reference Count : 1]

- startup_stm32f207xx.o(RESET)

CAN2_TX_IRQHandler (Thumb, 0 bytes, Stack size 0 bytes, startup_stm32f207xx.o(.text))
[Address Reference Count : 1]

- startup_stm32f207xx.o(RESET)

DCMI_IRQHandler (Thumb, 0 bytes, Stack size 0 bytes, startup_stm32f207xx.o(.text))
[Address Reference Count : 1]

- startup_stm32f207xx.o(RESET)

DMA1_Stream0_IRQHandler (Thumb, 0 bytes, Stack size 0 bytes, startup_stm32f207xx.o(.text))
[Address Reference Count : 1]

- startup_stm32f207xx.o(RESET)

DMA1_Stream1_IRQHandler (Thumb, 0 bytes, Stack size 0 bytes, startup_stm32f207xx.o(.text))
[Address Reference Count : 1]

- startup_stm32f207xx.o(RESET)

DMA1_Stream2_IRQHandler (Thumb, 0 bytes, Stack size 0 bytes, startup_stm32f207xx.o(.text))
[Address Reference Count : 1]

- startup_stm32f207xx.o(RESET)

DMA1_Stream3_IRQHandler (Thumb, 0 bytes, Stack size 0 bytes, startup_stm32f207xx.o(.text))
[Address Reference Count : 1]

- startup_stm32f207xx.o(RESET)

DMA1_Stream4_IRQHandler (Thumb, 0 bytes, Stack size 0 bytes, startup_stm32f207xx.o(.text))
[Address Reference Count : 1]

- startup_stm32f207xx.o(RESET)

DMA1_Stream5_IRQHandler (Thumb, 0 bytes, Stack size 0 bytes, startup_stm32f207xx.o(.text))
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

TIM2_IRQHandler (Thumb, 0 bytes, Stack size 0 bytes, startup_stm32f207xx.o(.text))
[Address Reference Count : 1]

- startup_stm32f207xx.o(RESET)

TIM3_IRQHandler (Thumb, 0 bytes, Stack size 0 bytes, startup_stm32f207xx.o(.text))
[Address Reference Count : 1]

- startup_stm32f207xx.o(RESET)

TIM4_IRQHandler (Thumb, 0 bytes, Stack size 0 bytes, startup_stm32f207xx.o(.text))
[Address Reference Count : 1]

- startup_stm32f207xx.o(RESET)

TIM5_IRQHandler (Thumb, 0 bytes, Stack size 0 bytes, startup_stm32f207xx.o(.text))
[Address Reference Count : 1]

- startup_stm32f207xx.o(RESET)

TIM6_DAC_IRQHandler (Thumb, 0 bytes, Stack size 0 bytes, startup_stm32f207xx.o(.text))
[Address Reference Count : 1]

- startup_stm32f207xx.o(RESET)

TIM7_IRQHandler (Thumb, 0 bytes, Stack size 0 bytes, startup_stm32f207xx.o(.text))
[Address Reference Count : 1]

- startup_stm32f207xx.o(RESET)

TIM8_BRK_TIM12_IRQHandler (Thumb, 0 bytes, Stack size 0 bytes, startup_stm32f207xx.o(.text))
[Address Reference Count : 1]

- startup_stm32f207xx.o(RESET)

TIM8_CC_IRQHandler (Thumb, 0 bytes, Stack size 0 bytes, startup_stm32f207xx.o(.text))
[Address Reference Count : 1]

- startup_stm32f207xx.o(RESET)

TIM8_TRG_COM_TIM14_IRQHandler (Thumb, 0 bytes, Stack size 0 bytes, startup_stm32f207xx.o(.text))
[Address Reference Count : 1]

- startup_stm32f207xx.o(RESET)

TIM8_UP_TIM13_IRQHandler (Thumb, 0 bytes, Stack size 0 bytes, startup_stm32f207xx.o(.text))
[Address Reference Count : 1]

- startup_stm32f207xx.o(RESET)

UART4_IRQHandler (Thumb, 0 bytes, Stack size 0 bytes, startup_stm32f207xx.o(.text))
[Address Reference Count : 1]

- startup_stm32f207xx.o(RESET)

UART5_IRQHandler (Thumb, 0 bytes, Stack size 0 bytes, startup_stm32f207xx.o(.text))
[Address Reference Count : 1]

- startup_stm32f207xx.o(RESET)

USART1_IRQHandler (Thumb, 0 bytes, Stack size 0 bytes, startup_stm32f207xx.o(.text))
[Address Reference Count : 1]

- startup_stm32f207xx.o(RESET)

USART2_IRQHandler (Thumb, 0 bytes, Stack size 0 bytes, startup_stm32f207xx.o(.text))
[Address Reference Count : 1]

- startup_stm32f207xx.o(RESET)

USART3_IRQHandler (Thumb, 0 bytes, Stack size 0 bytes, startup_stm32f207xx.o(.text))
[Address Reference Count : 1]

- startup_stm32f207xx.o(RESET)

USART6_IRQHandler (Thumb, 0 bytes, Stack size 0 bytes, startup_stm32f207xx.o(.text))
[Address Reference Count : 1]

- startup_stm32f207xx.o(RESET)

WWDG_IRQHandler (Thumb, 0 bytes, Stack size 0 bytes, startup_stm32f207xx.o(.text))
[Address Reference Count : 1]

- startup_stm32f207xx.o(RESET)

__aeabi_memcpy (Thumb, 36 bytes, Stack size 0 bytes, memcpya.o(.text))

[Called By]

- >> SD_write
- >> SD_read

__aeabi_memcpy4 (Thumb, 0 bytes, Stack size 0 bytes, memcpya.o(.text), UNUSED)

__aeabi_memcpy8 (Thumb, 0 bytes, Stack size 0 bytes, memcpya.o(.text), UNUSED)

__scatterload (Thumb, 28 bytes, Stack size 0 bytes, init.o(.text))

[Calls]

- >> __main_after_scatterload

[Called By]

- >> _main_scatterload

__scatterload_rt2 (Thumb, 0 bytes, Stack size 0 bytes, init.o(.text), UNUSED)

BSP_SD_GetCardInfo (Thumb, 8 bytes, Stack size 0 bytes, bsp_driver_sd.o(i.BSP_SD_GetCardInfo))

[Stack]

- Max Depth = 28
- Call Chain = BSP_SD_GetCardInfo ⇒ HAL_SD_Get_CardInfo

[Calls]

- >> HAL_SD_Get_CardInfo

[Called By]

- >> SD_ioctl

BSP_SD_GetStatus (Thumb, 6 bytes, Stack size 0 bytes, bsp_driver_sd.o(i.BSP_SD_GetStatus))

[Stack]

- Max Depth = 64
- Call Chain = BSP_SD_GetStatus ⇒ HAL_SD_GetStatus ⇒ SD_CmdResp1Error ⇒ SDIO_GetResponse

[Calls]

- >> HAL_SD_GetStatus

[Called By]

- >> SD_write
- >> SD_status
- >> SD_read

BSP_SD_Init (Thumb, 72 bytes, Stack size 24 bytes, bsp_driver_sd.o(i.BSP_SD_Init))

[Stack]

- Max Depth = 240
- Call Chain = BSP_SD_Init ⇒ HAL_SD_WideBusOperation_Config ⇒ SD_WideBus_Enable ⇒ SD_FindSCR ⇒ SD_CmdResp1Error ⇒ SDIO_GetResponse

[Calls]

- >> HAL_SD_WideBusOperation_Config
- >> HAL_SD_Init
- >> HAL_SD_GetCardStatus

[Called By]

- >> SD_initialize

BSP_SD_ReadBlocks_DMA (Thumb, 44 bytes, Stack size 24 bytes, bsp_driver_sd.o(i.BSP_SD_ReadBlocks_DMA))

[Stack]

- Max Depth = 136
- Call Chain = BSP_SD_ReadBlocks_DMA ⇒ HAL_SD_ReadBlocks_DMA ⇒ HAL_DMA_Start_IT ⇒ DMA_SetConfig

[Calls]

- >> HAL_SD_ReadBlocks_DMA
- >> HAL_SD_CheckReadOperation

[Called By]

- >> SD_read

BSP_SD_WriteBlocks_DMA (Thumb, 44 bytes, Stack size 24 bytes, bsp_driver_sd.o(i.BSP_SD_WriteBlocks_DMA))

[Stack]

- Max Depth = 136
- Call Chain = BSP_SD_WriteBlocks_DMA ⇒ HAL_SD_WriteBlocks_DMA ⇒ HAL_DMA_Start_IT ⇒ DMA_SetConfig

[Calls]

- >> HAL_SD_WriteBlocks_DMA
- >> HAL_SD_CheckWriteOperation

[Called By]

- >> SD_write

FATFS_LinkDriver (Thumb, 44 bytes, Stack size 8 bytes, ff_gen_drv.o(i.FATFS_LinkDriver))

[Stack]

- Max Depth = 8
- Call Chain = FATFS_LinkDriver

[Called By]

- >> main

HAL_ADC_ConfigChannel (Thumb, 430 bytes, Stack size 16 bytes, stm32f2xx_hal_adc.o(i.HAL_ADC_ConfigChannel))

[Stack]

- Max Depth = 16
- Call Chain = HAL_ADC_ConfigChannel

[Calls]

- >> assert_failed

[Called By]

- >> MX_ADC3_Init
- >> MX_ADC2_Init
- >> MX_ADC1_Init
- >> main

HAL_ADC_GetValue (Thumb, 6 bytes, Stack size 0 bytes, stm32f2xx_hal_adc.o(i.HAL_ADC_GetValue))

[Called By]

- >> main

HAL_ADC_Init (Thumb, 396 bytes, Stack size 24 bytes, stm32f2xx_hal_adc.o(i.HAL_ADC_Init))

[Stack]

- Max Depth = 104
- Call Chain = HAL_ADC_Init ⇒ HAL_ADC_MspInit ⇒ HAL_GPIO_Init

[Calls]

- >> assert_failed
- >> ADC_Init
- >> HAL_ADC_MspInit

[Called By]

- >> MX_ADC3_Init
- >> MX_ADC2_Init
- >> MX_ADC1_Init
- >> main

HAL_ADC_MspInit (Thumb, 142 bytes, Stack size 40 bytes, adc.o(i.HAL_ADC_MspInit))

[Stack]

- Max Depth = 80
- Call Chain = HAL_ADC_MspInit ⇒ HAL_GPIO_Init

[Calls]

- >> HAL_GPIO_Init
- >> HAL_DMA_Init

[Called By]

- >> HAL_ADC_Init
- >> main

HAL_ADC_PollForConversion (Thumb, 72 bytes, Stack size 16 bytes, stm32f2xx_hal_adc.o(i.HAL_ADC_PollForConversion))

[Stack]

- Max Depth = 16
- Call Chain = HAL_ADC_PollForConversion

[Calls]

- >> HAL_GetTick

[Called By]

- >> main

HAL_ADC_Start (Thumb, 168 bytes, Stack size 16 bytes, stm32f2xx_hal_adc.o(i.HAL_ADC_Start))

[Stack]

- Max Depth = 16
- Call Chain = HAL_ADC_Start

[Calls]

- >> assert_failed

[Called By]

- >> main

HAL_DMA_Init (Thumb, 566 bytes, Stack size 16 bytes, stm32f2xx_hal_dma.o(i.HAL_DMA_Init))

[Stack]

- Max Depth = 16
- Call Chain = HAL_DMA_Init

[Calls]

- >> assert_failed

[Called By]

- >> HAL_ADC_MspInit
- >> HAL_SD_MspInit
- >> HAL_TIM_Base_MspInit
- >> HAL_I2C_MspInit

HAL_DMA_Start_IT (Thumb, 144 bytes, Stack size 24 bytes, stm32f2xx_hal_dma.o(i.HAL_DMA_Start_IT))

[Stack]

- Max Depth = 32
- Call Chain = HAL_DMA_Start_IT ⇒ DMA_SetConfig

[Calls]

- >> assert_failed
- >> DMA_SetConfig

[Called By]

- >> HAL_SD_WriteBlocks_DMA
- >> HAL_SD_ReadBlocks_DMA

HAL_GPIO_Init (Thumb, 636 bytes, Stack size 40 bytes, stm32f2xx_hal_gpio.o(i.HAL_GPIO_Init))

[Stack]

- Max Depth = 40
- Call Chain = HAL_GPIO_Init

[Calls]

- >> assert_failed

[Called By]

- >> HAL_ADC_MspInit
- >> HAL_SPI_MspInit
- >> main
- >> HAL_SD_MspInit
- >> MX_GPIO_Init
- >> HAL_TIM_Base_MspInit
- >> HAL_I2C_MspInit

HAL_GPIO_WritePin (Thumb, 122 bytes, Stack size 16 bytes, stm32f2xx_hal_gpio.o(i.HAL_GPIO_WritePin))

[Stack]

- Max Depth = 16
- Call Chain = HAL_GPIO_WritePin

[Calls]

- >> assert_failed

[Called By]

- >> main

HAL_GetTick (Thumb, 6 bytes, Stack size 0 bytes, stm32f2xx_hal.o(i.HAL_GetTick))

[Called By]

- >> RTC_EnterInitMode
- >> HAL_ADC_PollForConversion
- >> HAL_RCC_OscConfig
- >> HAL_RCC_ClockConfig
- >> HAL_RTC_WaitForSynchro
- >> HAL_RTC_SetAlarm_IT
- >> HAL_RCCEx_PeriphCLKConfig

HAL_I2C_Init (Thumb, 428 bytes, Stack size 16 bytes, stm32f2xx_hal_i2c.o(i.HAL_I2C_Init))

[Stack]

- Max Depth = 96
- Call Chain = HAL_I2C_Init ⇒ HAL_I2C_MspInit ⇒ HAL_GPIO_Init

[Calls]

- >> assert_failed
- >> HAL_RCC_GetPCLK1Freq
- >> HAL_I2C_MspInit

[Called By]

- >> MX_I2C3_Init
- >> MX_I2C2_Init

HAL_I2C_MspInit (Thumb, 124 bytes, Stack size 40 bytes, i2c.o(i.HAL_I2C_MspInit))

[Stack]

- Max Depth = 80
- Call Chain = HAL_I2C_MspInit ⇒ HAL_GPIO_Init

[Calls]

- >> HAL_GPIO_Init
- >> HAL_DMA_Init

[Called By]

- >> HAL_I2C_Init

HAL_IWDG_Init (Thumb, 126 bytes, Stack size 8 bytes, stm32f2xx_hal_iwdg.o(i.HAL_IWDG_Init))

[Stack]

- Max Depth = 8
- Call Chain = HAL_IWDG_Init

[Calls]

- >> assert_failed
- >> HAL_IWDG_MspInit

[Called By]

- >> MX_IWDG_Init

HAL_IWDG_MspInit (Thumb, 2 bytes, Stack size 0 bytes, iwdg.o(i.HAL_IWDG_MspInit))

[Called By]

- >> HAL_IWDG_Init

HAL_IncTick (Thumb, 10 bytes, Stack size 0 bytes, stm32f2xx_hal.o(i.HAL_IncTick))

[Called By]

- >> SysTick_Handler

HAL_Init (Thumb, 50 bytes, Stack size 8 bytes, stm32f2xx_hal.o(i.HAL_Init))

[Stack]

- Max Depth = 32
- Call Chain = HAL_Init ⇒ HAL_MspInit ⇒ HAL_NVIC_SetPriority

[Calls]

- >> HAL_SYSTICK_Config
- >> HAL_NVIC_SetPriorityGrouping
- >> HAL_MspInit

[Called By]

- >> main

HAL_MspInit (Thumb, 22 bytes, Stack size 8 bytes, stm32f2xx_hal_msp.o(i.HAL_MspInit))

[Stack]

- Max Depth = 24
- Call Chain = HAL_MspInit ⇒ HAL_NVIC_SetPriority

[Calls]

- >> HAL_NVIC_SetPriorityGrouping
- >> HAL_NVIC_SetPriority

[Called By]

- >> HAL_Init

HAL_NVIC_EnableIRQ (Thumb, 22 bytes, Stack size 0 bytes, stm32f2xx_hal_cortex.o(i.HAL_NVIC_EnableIRQ))

[Called By]

- >> HAL_RTC_MspInit

HAL_NVIC_SetPriority (Thumb, 94 bytes, Stack size 16 bytes, stm32f2xx_hal_cortex.o(i.HAL_NVIC_SetPriority))

[Stack]

- Max Depth = 16
- Call Chain = HAL_NVIC_SetPriority

[Calls]

- >> assert_failed
- >> NVIC_SetPriority

[Called By]

- >> HAL_MspInit
- >> HAL_RTC_MspInit

HAL_NVIC_SetPriorityGrouping (Thumb, 58 bytes, Stack size 8 bytes, stm32f2xx_hal_cortex.o(i.HAL_NVIC_SetPriorityGrouping))

[Stack]

- Max Depth = 8
- Call Chain = HAL_NVIC_SetPriorityGrouping

[Calls]

- >> assert_failed

[Called By]

- >> HAL_Init
- >> HAL_MspInit

HAL_RCCEx_PeriphCLKConfig (Thumb, 354 bytes, Stack size 32 bytes, stm32f2xx_hal_rcc_ex.o(i.HAL_RCCEx_PeriphCLKConfig))

[Stack]

- Max Depth = 32
- Call Chain = HAL_RCCEx_PeriphCLKConfig

[Calls]

- >> assert_failed
- >> HAL_GetTick

[Called By]

- >> SystemClock_Config

HAL_RCC_ClockConfig (Thumb, 730 bytes, Stack size 32 bytes, stm32f2xx_hal_rcc.o(i.HAL_RCC_ClockConfig))

[Stack]

- Max Depth = 48
- Call Chain = HAL_RCC_ClockConfig ⇒ HAL_RCC_GetHCLKFreq ⇒ HAL_RCC_GetSysClockFreq

[Calls]

- >> assert_failed
- >> HAL_GetTick
- >> HAL_RCC_GetHCLKFreq

[Called By]

- >> SystemClock_Config

HAL_RCC_GetHCLKFreq (Thumb, 38 bytes, Stack size 4 bytes, stm32f2xx_hal_rcc.o(i.HAL_RCC_GetHCLKFreq))

[Stack]

- Max Depth = 16
- Call Chain = HAL_RCC_GetHCLKFreq ⇒ HAL_RCC_GetSysClockFreq

[Calls]

- >> HAL_RCC_GetSysClockFreq

[Called By]

- >> HAL_RCC_GetPCLK1Freq
- >> HAL_RCC_ClockConfig

HAL_RCC_GetPCLK1Freq (Thumb, 36 bytes, Stack size 4 bytes, stm32f2xx_hal_rcc.o(i.HAL_RCC_GetPCLK1Freq))

[Stack]

- Max Depth = 20
- Call Chain = HAL_RCC_GetPCLK1Freq ⇒ HAL_RCC_GetHCLKFreq ⇒ HAL_RCC_GetSysClockFreq

[Calls]

- >> HAL_RCC_GetHCLKFreq

[Called By]

- >> HAL_I2C_Init

HAL_RCC_GetSysClockFreq (Thumb, 120 bytes, Stack size 12 bytes, stm32f2xx_hal_rcc.o(i.HAL_RCC_GetSysClockFreq))

[Stack]

- Max Depth = 12
- Call Chain = HAL_RCC_GetSysClockFreq

[Called By]

- >> HAL_RCC_GetHCLKFreq

HAL_RCC_OscConfig (Thumb, 1092 bytes, Stack size 40 bytes, stm32f2xx_hal_rcc.o(i.HAL_RCC_OscConfig))

[Stack]

- Max Depth = 40
- Call Chain = HAL_RCC_OscConfig

[Calls]

- >> assert_failed
- >> HAL_GetTick

[Called By]

- >> SystemClock_Config

HAL_RTCEx_AlarmBEventCallback (Thumb, 2 bytes, Stack size 0 bytes, stm32f2xx_hal_rtc_ex.o(i.HAL_RTCEx_AlarmBEventCallback))

[Called By]

- >> HAL_RTC_AlarmIRQHandler

HAL_RTCEx_SetCalibrationOutPut (Thumb, 56 bytes, Stack size 0 bytes, stm32f2xx_hal_rtc_ex.o(i.HAL_RTCEx_SetCalibrationOutPut))

[Called By]

- >> MX_RTC_Init

HAL_RTC_AlarmAEventCallback (Thumb, 2 bytes, Stack size 0 bytes, stm32f2xx_hal_rtc.o(i.HAL_RTC_AlarmAEventCallback))

[Called By]

- >> HAL_RTC_AlarmIRQHandler

HAL_RTC_AlarmIRQHandler (Thumb, 86 bytes, Stack size 8 bytes, stm32f2xx_hal_rtc.o(i.HAL_RTC_AlarmIRQHandler))

[Stack]

- Max Depth = 8
- Call Chain = HAL_RTC_AlarmIRQHandler

[Calls]

- >> HAL_RTCEx_AlarmBEventCallback
- >> HAL_RTC_AlarmAEventCallback

[Called By]

- >> RTC_Alarm_IRQHandler

HAL_RTC_Init (Thumb, 258 bytes, Stack size 16 bytes, stm32f2xx_hal_rtc.o(i.HAL_RTC_Init))

[Stack]

- Max Depth = 40
- Call Chain = HAL_RTC_Init ⇒ HAL_RTC_MspInit ⇒ HAL_NVIC_SetPriority

[Calls]

- >> assert_failed
- >> RTC_EnterInitMode
- >> HAL_RTC_MspInit

[Called By]

- >> MX_RTC_Init

HAL_RTC_MspInit (Thumb, 38 bytes, Stack size 8 bytes, rtc.o(i.HAL_RTC_MspInit))

[Stack]

- Max Depth = 24
- Call Chain = HAL_RTC_MspInit ⇒ HAL_NVIC_SetPriority

[Calls]

- >> HAL_NVIC_SetPriority
- >> HAL_NVIC_EnableIRQ

[Called By]

- >> HAL_RTC_Init

HAL_RTC_SetAlarm_IT (Thumb, 742 bytes, Stack size 32 bytes, stm32f2xx_hal_rtc.o(i.HAL_RTC_SetAlarm_IT))

[Stack]

- Max Depth = 32
- Call Chain = HAL_RTC_SetAlarm_IT

[Calls]

- >> assert_failed
- >> RTC_Bcd2ToByte
- >> HAL_GetTick
- >> RTC_ByteToBcd2

[Called By]

- >> MX_RTC_Init

HAL_RTC_SetDate (Thumb, 366 bytes, Stack size 32 bytes, stm32f2xx_hal_rtc.o(i.HAL_RTC_SetDate))

[Stack]

- Max Depth = 48
- Call Chain = HAL_RTC_SetDate ⇒ RTC_EnterInitMode

[Calls]

- >> assert_failed
- >> RTC_EnterInitMode
- >> RTC_Bcd2ToByte
- >> RTC_ByteToBcd2
- >> HAL_RTC_WaitForSynchro

[Called By]

- >> MX_RTC_Init

HAL_RTC_SetTime (Thumb, 462 bytes, Stack size 32 bytes, stm32f2xx_hal_rtc.o(i.HAL_RTC_SetTime))

[Stack]

- Max Depth = 48
- Call Chain = HAL_RTC_SetTime ⇒ RTC_EnterInitMode

[Calls]

- >> assert_failed
- >> RTC_EnterInitMode
- >> RTC_Bcd2ToByte
- >> RTC_ByteToBcd2
- >> HAL_RTC_WaitForSynchro

[Called By]

- >> MX_RTC_Init

HAL_RTC_WaitForSynchro (Thumb, 48 bytes, Stack size 16 bytes, stm32f2xx_hal_rtc.o(i.HAL_RTC_WaitForSynchro))

[Stack]

- Max Depth = 16
- Call Chain = HAL_RTC_WaitForSynchro

[Calls]

- >> HAL_GetTick

[Called By]

- >> HAL_RTC_SetTime
- >> HAL_RTC_SetDate

HAL_SD_CheckReadOperation (Thumb, 94 bytes, Stack size 16 bytes, stm32f2xx_hal_sd.o(i.HAL_SD_CheckReadOperation))

[Stack]

- Max Depth = 80
- Call Chain = HAL_SD_CheckReadOperation ⇒ HAL_SD_StopTransfer ⇒ SD_CmdResp1Error ⇒ SDIO_GetResponse

[Calls]

- >> HAL_SD_StopTransfer

[Called By]

- >> BSP_SD_ReadBlocks_DMA

HAL_SD_CheckWriteOperation (Thumb, 108 bytes, Stack size 16 bytes, stm32f2xx_hal_sd.o(i.HAL_SD_CheckWriteOperation))

[Stack]

- Max Depth = 80
- Call Chain = HAL_SD_CheckWriteOperation ⇒ HAL_SD_StopTransfer ⇒ SD_CmdResp1Error ⇒ SDIO_GetResponse

[Calls]

- >> HAL_SD_StopTransfer
- >> HAL_SD_GetStatus

[Called By]

- >> BSP_SD_WriteBlocks_DMA

HAL_SD_DMA_RxCpltCallback (Thumb, 2 bytes, Stack size 0 bytes, stm32f2xx_hal_sd.o(i.HAL_SD_DMA_RxCpltCallback))

[Called By]

- >> SD_DMA_RxCplt

HAL_SD_DMA_RxErrorCallback (Thumb, 2 bytes, Stack size 0 bytes, stm32f2xx_hal_sd.o(i.HAL_SD_DMA_RxErrorCallback))

[Called By]

- >> SD_DMA_RxError

HAL_SD_DMA_TxCpltCallback (Thumb, 2 bytes, Stack size 0 bytes, stm32f2xx_hal_sd.o(i.HAL_SD_DMA_TxCpltCallback))

[Called By]

- >> SD_DMA_TxCplt

HAL_SD_DMA_TxErrorCallback (Thumb, 2 bytes, Stack size 0 bytes, stm32f2xx_hal_sd.o(i.HAL_SD_DMA_TxErrorCallback))

[Called By]

- >> SD_DMA_TxError

HAL_SD_GetCardStatus (Thumb, 114 bytes, Stack size 72 bytes, stm32f2xx_hal_sd.o(i.HAL_SD_GetCardStatus))

[Stack]

- Max Depth = 184
- Call Chain = HAL_SD_GetCardStatus ⇒ HAL_SD_SendSDStatus ⇒ SD_CmdResp1Error ⇒ SDIO_GetResponse

[Calls]

- >> HAL_SD_SendSDStatus

[Called By]

- >> BSP_SD_Init

HAL_SD_GetStatus (Thumb, 78 bytes, Stack size 32 bytes, stm32f2xx_hal_sd.o(i.HAL_SD_GetStatus))

[Stack]

- Max Depth = 64
- Call Chain = HAL_SD_GetStatus ⇒ SD_CmdResp1Error ⇒ SDIO_GetResponse

[Calls]

- >> SD_CmdResp1Error
- >> SDIO_SendCommand
- >> SDIO_GetResponse

[Called By]

- >> BSP_SD_GetStatus
- >> HAL_SD_CheckWriteOperation

HAL_SD_Get_CardInfo (Thumb, 668 bytes, Stack size 28 bytes, stm32f2xx_hal_sd.o(i.HAL_SD_Get_CardInfo))

[Stack]

- Max Depth = 28
- Call Chain = HAL_SD_Get_CardInfo

[Called By]

- >> BSP_SD_GetCardInfo
- >> HAL_SD_Init

HAL_SD_Init (Thumb, 158 bytes, Stack size 40 bytes, stm32f2xx_hal_sd.o(i.HAL_SD_Init))

[Stack]

- Max Depth = 136
- Call Chain = HAL_SD_Init ⇒ SD_PowerON ⇒ SD_CmdResp1Error ⇒ SDIO_GetResponse

[Calls]

- >> HAL_SD_Get_CardInfo
- >> SD_PowerON
- >> SD_Initialize_Cards
- >> SD_CmdResp1Error
- >> SDIO_SendCommand
- >> SDIO_Init
- >> HAL_SD_MspInit

[Called By]

- >> BSP_SD_Init

HAL_SD_MspInit (Thumb, 134 bytes, Stack size 48 bytes, sdio.o(i.HAL_SD_MspInit))

[Stack]

- Max Depth = 88
- Call Chain = HAL_SD_MspInit ⇒ HAL_GPIO_Init

[Calls]

- >> HAL_GPIO_Init
- >> HAL_DMA_Init

[Called By]

- >> HAL_SD_Init

HAL_SD_ReadBlocks_DMA (Thumb, 224 bytes, Stack size 80 bytes, stm32f2xx_hal_sd.o(i.HAL_SD_ReadBlocks_DMA))

[Stack]

- Max Depth = 112
- Call Chain = HAL_SD_ReadBlocks_DMA ⇒ HAL_DMA_Start_IT ⇒ DMA_SetConfig

[Calls]

- >> HAL_DMA_Start_IT
- >> SD_CmdResp1Error
- >> SDIO_SendCommand
- >> SDIO_DataConfig

[Called By]

- >> BSP_SD_ReadBlocks_DMA

HAL_SD_SendSDStatus (Thumb, 296 bytes, Stack size 80 bytes, stm32f2xx_hal_sd.o(i.HAL_SD_SendSDStatus))

[Stack]

- Max Depth = 112
- Call Chain = HAL_SD_SendSDStatus ⇒ SD_CmdResp1Error ⇒ SDIO_GetResponse

[Calls]

- >> SD_CmdResp1Error
- >> SDIO_SendCommand
- >> SDIO_ReadFIFO
- >> SDIO_GetResponse
- >> SDIO_DataConfig

[Called By]

- >> HAL_SD_GetCardStatus

HAL_SD_StopTransfer (Thumb, 44 bytes, Stack size 32 bytes, stm32f2xx_hal_sd.o(i.HAL_SD_StopTransfer))

[Stack]

- Max Depth = 64
- Call Chain = HAL_SD_StopTransfer ⇒ SD_CmdResp1Error ⇒ SDIO_GetResponse

[Calls]

- >> SD_CmdResp1Error
- >> SDIO_SendCommand

[Called By]

- >> HAL_SD_CheckWriteOperation
- >> HAL_SD_CheckReadOperation

HAL_SD_WideBusOperation_Config (Thumb, 92 bytes, Stack size 32 bytes, stm32f2xx_hal_sd.o(i.HAL_SD_WideBusOperation_Config))

[Stack]

- Max Depth = 216
- Call Chain = HAL_SD_WideBusOperation_Config ⇒ SD_WideBus_Enable ⇒ SD_FindSCR ⇒ SD_CmdResp1Error ⇒ SDIO_GetResponse

[Calls]

- >> SD_WideBus_Enable
- >> SD_WideBus_Disable
- >> SDIO_Init

[Called By]

- >> BSP_SD_Init

HAL_SD_WriteBlocks_DMA (Thumb, 226 bytes, Stack size 80 bytes, stm32f2xx_hal_sd.o(i.HAL_SD_WriteBlocks_DMA))

[Stack]

- Max Depth = 112
- Call Chain = HAL_SD_WriteBlocks_DMA ⇒ HAL_DMA_Start_IT ⇒ DMA_SetConfig

[Calls]

- >> HAL_DMA_Start_IT
- >> SD_CmdResp1Error
- >> SDIO_SendCommand
- >> SDIO_DataConfig

[Called By]

- >> BSP_SD_WriteBlocks_DMA

HAL_SPI_Init (Thumb, 358 bytes, Stack size 8 bytes, stm32f2xx_hal_spi.o(i.HAL_SPI_Init))

[Stack]

- Max Depth = 72
- Call Chain = HAL_SPI_Init ⇒ HAL_SPI_MspInit ⇒ HAL_GPIO_Init

[Calls]

- >> assert_failed
- >> HAL_SPI_MspInit

[Called By]

- >> MX_SPI1_Init

HAL_SPI_MspInit (Thumb, 52 bytes, Stack size 24 bytes, spi.o(i.HAL_SPI_MspInit))

[Stack]

- Max Depth = 64
- Call Chain = HAL_SPI_MspInit ⇒ HAL_GPIO_Init

[Calls]

- >> HAL_GPIO_Init

[Called By]

- >> HAL_SPI_Init

HAL_SYSTICK_Callback (Thumb, 2 bytes, Stack size 0 bytes, stm32f2xx_hal_cortex.o(i.HAL_SYSTICK_Callback))

[Called By]

- >> HAL_SYSTICK_IRQHandler

HAL_SYSTICK_Config (Thumb, 40 bytes, Stack size 8 bytes, stm32f2xx_hal_cortex.o(i.HAL_SYSTICK_Config))

[Stack]

- Max Depth = 8
- Call Chain = HAL_SYSTICK_Config

[Calls]

- >> NVIC_SetPriority

[Called By]

- >> HAL_Init

HAL_SYSTICK_IRQHandler (Thumb, 8 bytes, Stack size 8 bytes, stm32f2xx_hal_cortex.o(i.HAL_SYSTICK_IRQHandler))

[Stack]

- Max Depth = 8
- Call Chain = HAL_SYSTICK_IRQHandler

[Calls]

- >> HAL_SYSTICK_Callback

[Called By]

- >> SysTick_Handler

HAL_TIMEx_MasterConfigSynchronization (Thumb, 214 bytes, Stack size 16 bytes, stm32f2xx_hal_tim_ex.o(i.HAL_TIMEx_MasterConfigSynchronization))

[Stack]

- Max Depth = 16
- Call Chain = HAL_TIMEx_MasterConfigSynchronization

[Calls]

- >> assert_failed

[Called By]

- >> MX_TIM1_Init

HAL_TIM_Base_Init (Thumb, 194 bytes, Stack size 8 bytes, stm32f2xx_hal_tim.o(i.HAL_TIM_Base_Init))

[Stack]

- Max Depth = 88
- Call Chain = HAL_TIM_Base_Init ⇒ HAL_TIM_Base_MspInit ⇒ HAL_GPIO_Init

[Calls]

- >> assert_failed
- >> TIM_Base_SetConfig
- >> HAL_TIM_Base_MspInit

[Called By]

- >> MX_TIM1_Init

HAL_TIM_Base_MspInit (Thumb, 92 bytes, Stack size 40 bytes, tim.o(i.HAL_TIM_Base_MspInit))

[Stack]

- Max Depth = 80
- Call Chain = HAL_TIM_Base_MspInit ⇒ HAL_GPIO_Init

[Calls]

- >> HAL_GPIO_Init
- >> HAL_DMA_Init

[Called By]

- >> HAL_TIM_Base_Init

HAL_TIM_IC_ConfigChannel (Thumb, 574 bytes, Stack size 40 bytes, stm32f2xx_hal_tim.o(i.HAL_TIM_IC_ConfigChannel))

[Stack]

- Max Depth = 56
- Call Chain = HAL_TIM_IC_ConfigChannel ⇒ TIM_TI1_SetConfig

[Calls]

- >> assert_failed
- >> TIM_TI1_SetConfig
- >> TIM_TI2_SetConfig

[Called By]

- >> MX_TIM1_Init

HAL_TIM_IC_Init (Thumb, 200 bytes, Stack size 8 bytes, stm32f2xx_hal_tim.o(i.HAL_TIM_IC_Init))

[Stack]

- Max Depth = 28
- Call Chain = HAL_TIM_IC_Init ⇒ TIM_Base_SetConfig

[Calls]

- >> assert_failed
- >> TIM_Base_SetConfig
- >> HAL_TIM_IC_MspInit

[Called By]

- >> MX_TIM1_Init

HAL_TIM_IC_MspInit (Thumb, 2 bytes, Stack size 0 bytes, stm32f2xx_hal_tim.o(i.HAL_TIM_IC_MspInit))

[Called By]

- >> HAL_TIM_IC_Init

HAL_TIM_OnePulse_Init (Thumb, 236 bytes, Stack size 16 bytes, stm32f2xx_hal_tim.o(i.HAL_TIM_OnePulse_Init))

[Stack]

- Max Depth = 36
- Call Chain = HAL_TIM_OnePulse_Init ⇒ TIM_Base_SetConfig

[Calls]

- >> assert_failed
- >> TIM_Base_SetConfig
- >> HAL_TIM_OnePulse_MspInit

[Called By]

- >> MX_TIM1_Init

HAL_TIM_OnePulse_MspInit (Thumb, 2 bytes, Stack size 0 bytes, stm32f2xx_hal_tim.o(i.HAL_TIM_OnePulse_MspInit))

[Called By]

- >> HAL_TIM_OnePulse_Init

HAL_TIM_SlaveConfigSynchronization (Thumb, 902 bytes, Stack size 40 bytes, stm32f2xx_hal_tim.o(i.HAL_TIM_SlaveConfigSynchronization))

[Stack]

- Max Depth = 48
- Call Chain = HAL_TIM_SlaveConfigSynchronization ⇒ TIM_TI2_ConfigInputStage

[Calls]

- >> assert_failed
- >> TIM_TI2_ConfigInputStage
- >> TIM_TI1_ConfigInputStage
- >> TIM_ETR_SetConfig

[Called By]

- >> MX_TIM1_Init

HAL_WWDG_Init (Thumb, 124 bytes, Stack size 8 bytes, stm32f2xx_hal_wwdg.o(i.HAL_WWDG_Init))

[Stack]

- Max Depth = 8
- Call Chain = HAL_WWDG_Init

[Calls]

- >> assert_failed
- >> HAL_WWDG_MspInit

[Called By]

- >> MX_WWDG_Init

HAL_WWDG_MspInit (Thumb, 20 bytes, Stack size 0 bytes, wwdg.o(i.HAL_WWDG_MspInit))

[Called By]

- >> HAL_WWDG_Init

MX_ADC1_Init (Thumb, 52 bytes, Stack size 32 bytes, adc.o(i.MX_ADC1_Init))

[Stack]

- Max Depth = 136
- Call Chain = MX_ADC1_Init ⇒ HAL_ADC_Init ⇒ HAL_ADC_MspInit ⇒ HAL_GPIO_Init

[Calls]

- >> HAL_ADC_Init
- >> HAL_ADC_ConfigChannel

[Called By]

- >> main

MX_ADC2_Init (Thumb, 52 bytes, Stack size 32 bytes, adc.o(i.MX_ADC2_Init))

[Stack]

- Max Depth = 136
- Call Chain = MX_ADC2_Init ⇒ HAL_ADC_Init ⇒ HAL_ADC_MspInit ⇒ HAL_GPIO_Init

[Calls]

- >> HAL_ADC_Init
- >> HAL_ADC_ConfigChannel

[Called By]

- >> main

MX_ADC3_Init (Thumb, 52 bytes, Stack size 32 bytes, adc.o(i.MX_ADC3_Init))

[Stack]

- Max Depth = 136
- Call Chain = MX_ADC3_Init ⇒ HAL_ADC_Init ⇒ HAL_ADC_MspInit ⇒ HAL_GPIO_Init

[Calls]

- >> HAL_ADC_Init
- >> HAL_ADC_ConfigChannel

[Called By]

- >> main

MX_DMA_Init (Thumb, 20 bytes, Stack size 0 bytes, dma.o(i.MX_DMA_Init))

[Called By]

- >> main

MX_GPIO_Init (Thumb, 330 bytes, Stack size 40 bytes, gpio.o(i.MX_GPIO_Init))

[Stack]

- Max Depth = 80
- Call Chain = MX_GPIO_Init ⇒ HAL_GPIO_Init

[Calls]

- >> HAL_GPIO_Init

[Called By]

- >> main

MX_I2C2_Init (Thumb, 34 bytes, Stack size 0 bytes, i2c.o(i.MX_I2C2_Init))

[Stack]

- Max Depth = 96
- Call Chain = MX_I2C2_Init ⇒ HAL_I2C_Init ⇒ HAL_I2C_MspInit ⇒ HAL_GPIO_Init

[Calls]

- >> HAL_I2C_Init

[Called By]

- >> main

MX_I2C3_Init (Thumb, 34 bytes, Stack size 0 bytes, i2c.o(i.MX_I2C3_Init))

[Stack]

- Max Depth = 96
- Call Chain = MX_I2C3_Init ⇒ HAL_I2C_Init ⇒ HAL_I2C_MspInit ⇒ HAL_GPIO_Init

[Calls]

- >> HAL_I2C_Init

[Called By]

- >> main

MX_IWDG_Init (Thumb, 20 bytes, Stack size 0 bytes, iwdg.o(i.MX_IWDG_Init))

[Stack]

- Max Depth = 8
- Call Chain = MX_IWDG_Init ⇒ HAL_IWDG_Init

[Calls]

- >> HAL_IWDG_Init

[Called By]

- >> main

MX_RTC_Init (Thumb, 128 bytes, Stack size 56 bytes, rtc.o(i.MX_RTC_Init))

[Stack]

- Max Depth = 104
- Call Chain = MX_RTC_Init ⇒ HAL_RTC_SetTime ⇒ RTC_EnterInitMode

[Calls]

- >> HAL_RTCEx_SetCalibrationOutPut
- >> HAL_RTC_SetTime
- >> HAL_RTC_SetDate
- >> HAL_RTC_SetAlarm_IT
- >> HAL_RTC_Init

[Called By]

- >> main

MX_SDIO_SD_Init (Thumb, 22 bytes, Stack size 0 bytes, sdio.o(i.MX_SDIO_SD_Init))

[Called By]

- >> main

MX_SPI1_Init (Thumb, 40 bytes, Stack size 0 bytes, spi.o(i.MX_SPI1_Init))

[Stack]

- Max Depth = 72
- Call Chain = MX_SPI1_Init ⇒ HAL_SPI_Init ⇒ HAL_SPI_MspInit ⇒ HAL_GPIO_Init

[Calls]

- >> HAL_SPI_Init

[Called By]

- >> main

MX_TIM1_Init (Thumb, 92 bytes, Stack size 56 bytes, tim.o(i.MX_TIM1_Init))

[Stack]

- Max Depth = 144
- Call Chain = MX_TIM1_Init ⇒ HAL_TIM_Base_Init ⇒ HAL_TIM_Base_MspInit ⇒ HAL_GPIO_Init

[Calls]

- >> HAL_TIMEx_MasterConfigSynchronization
- >> HAL_TIM_SlaveConfigSynchronization
- >> HAL_TIM_OnePulse_Init
- >> HAL_TIM_IC_Init
- >> HAL_TIM_IC_ConfigChannel
- >> HAL_TIM_Base_Init

[Called By]

- >> main

MX_USB_OTG_FS_USB_Init (Thumb, 2 bytes, Stack size 0 bytes, usb_otg.o(i.MX_USB_OTG_FS_USB_Init))

[Called By]

- >> main

MX_WWDG_Init (Thumb, 20 bytes, Stack size 0 bytes, wwdg.o(i.MX_WWDG_Init))

[Stack]

- Max Depth = 8
- Call Chain = MX_WWDG_Init ⇒ HAL_WWDG_Init

[Calls]

- >> HAL_WWDG_Init

[Called By]

- >> main

RTC_Alarm_IRQHandler (Thumb, 6 bytes, Stack size 0 bytes, stm32f2xx_it.o(i.RTC_Alarm_IRQHandler))

[Stack]

- Max Depth = 8
- Call Chain = RTC_Alarm_IRQHandler ⇒ HAL_RTC_AlarmIRQHandler

[Calls]

- >> HAL_RTC_AlarmIRQHandler

[Address Reference Count : 1]

- startup_stm32f207xx.o(RESET)

RTC_Bcd2ToByte (Thumb, 18 bytes, Stack size 0 bytes, stm32f2xx_hal_rtc.o(i.RTC_Bcd2ToByte))

[Called By]

- >> HAL_RTC_SetTime
- >> HAL_RTC_SetDate
- >> HAL_RTC_SetAlarm_IT

RTC_ByteToBcd2 (Thumb, 22 bytes, Stack size 0 bytes, stm32f2xx_hal_rtc.o(i.RTC_ByteToBcd2))

[Called By]

- >> HAL_RTC_SetTime
- >> HAL_RTC_SetDate
- >> HAL_RTC_SetAlarm_IT

RTC_EnterInitMode (Thumb, 52 bytes, Stack size 16 bytes, stm32f2xx_hal_rtc.o(i.RTC_EnterInitMode))

[Stack]

- Max Depth = 16
- Call Chain = RTC_EnterInitMode

[Calls]

- >> HAL_GetTick

[Called By]

- >> HAL_RTC_SetTime
- >> HAL_RTC_SetDate
- >> HAL_RTC_Init

SDIO_DataConfig (Thumb, 184 bytes, Stack size 16 bytes, stm32f2xx_ll_sdmmc.o(i.SDIO_DataConfig))

[Stack]

- Max Depth = 16
- Call Chain = SDIO_DataConfig

[Calls]

- >> assert_failed

[Called By]

- >> HAL_SD_WriteBlocks_DMA
- >> HAL_SD_SendSDStatus
- >> HAL_SD_ReadBlocks_DMA
- >> SD_FindSCR

SDIO_GetCommandResponse (Thumb, 6 bytes, Stack size 0 bytes, stm32f2xx_ll_sdmmc.o(i.SDIO_GetCommandResponse))

[Called By]

- >> SD_CmdResp6Error
- >> SD_CmdResp1Error

SDIO_GetPowerState (Thumb, 8 bytes, Stack size 0 bytes, stm32f2xx_ll_sdmmc.o(i.SDIO_GetPowerState))

[Called By]

- >> SD_Initialize_Cards

SDIO_GetResponse (Thumb, 44 bytes, Stack size 16 bytes, stm32f2xx_ll_sdmmc.o(i.SDIO_GetResponse))

[Stack]

- Max Depth = 16
- Call Chain = SDIO_GetResponse

[Calls]

- >> assert_failed

[Called By]

- >> HAL_SD_SendSDStatus
- >> HAL_SD_GetStatus
- >> SD_WideBus_Enable
- >> SD_WideBus_Disable
- >> SD_PowerON
- >> SD_Initialize_Cards
- >> SD_CmdResp6Error
- >> SD_CmdResp1Error

SDIO_Init (Thumb, 178 bytes, Stack size 40 bytes, stm32f2xx_ll_sdmmc.o(i.SDIO_Init))

[Stack]

- Max Depth = 40
- Call Chain = SDIO_Init

[Calls]

- >> assert_failed

[Called By]

- >> HAL_SD_WideBusOperation_Config
- >> HAL_SD_Init

SDIO_PowerState_ON (Thumb, 8 bytes, Stack size 0 bytes, stm32f2xx_ll_sdmmc.o(i.SDIO_PowerState_ON))

[Called By]

- >> SD_PowerON

SDIO_ReadFIFO (Thumb, 6 bytes, Stack size 0 bytes, stm32f2xx_ll_sdmmc.o(i.SDIO_ReadFIFO))

[Called By]

- >> HAL_SD_SendSDStatus
- >> SD_FindSCR

SDIO_SendCommand (Thumb, 122 bytes, Stack size 16 bytes, stm32f2xx_ll_sdmmc.o(i.SDIO_SendCommand))

[Stack]

- Max Depth = 16
- Call Chain = SDIO_SendCommand

[Calls]

- >> assert_failed

[Called By]

- >> HAL_SD_WriteBlocks_DMA
- >> HAL_SD_StopTransfer
- >> HAL_SD_SendSDStatus
- >> HAL_SD_ReadBlocks_DMA
- >> HAL_SD_Init
- >> HAL_SD_GetStatus
- >> SD_WideBus_Enable
- >> SD_WideBus_Disable
- >> SD_PowerON
- >> SD_Initialize_Cards
- >> SD_FindSCR

SD_initialize (Thumb, 26 bytes, Stack size 8 bytes, sd_diskio.o(i.SD_initialize))

[Stack]

- Max Depth = 248
- Call Chain = SD_initialize ⇒ BSP_SD_Init ⇒ HAL_SD_WideBusOperation_Config ⇒ SD_WideBus_Enable ⇒ SD_FindSCR ⇒ SD_CmdResp1Error ⇒ SDIO_GetResponse

[Calls]

- >> BSP_SD_Init

[Address Reference Count : 1]

- sd_diskio.o(.data)

SD_ioctl (Thumb, 76 bytes, Stack size 96 bytes, sd_diskio.o(i.SD_ioctl))

[Stack]

- Max Depth = 124
- Call Chain = SD_ioctl ⇒ BSP_SD_GetCardInfo ⇒ HAL_SD_Get_CardInfo

[Calls]

- >> BSP_SD_GetCardInfo

[Address Reference Count : 1]

- sd_diskio.o(.data)

SD_read (Thumb, 130 bytes, Stack size 552 bytes, sd_diskio.o(i.SD_read))

[Stack]

- Max Depth = 688
- Call Chain = SD_read ⇒ BSP_SD_ReadBlocks_DMA ⇒ HAL_SD_ReadBlocks_DMA ⇒ HAL_DMA_Start_IT ⇒ DMA_SetConfig

[Calls]

- >> BSP_SD_ReadBlocks_DMA
- >> BSP_SD_GetStatus
- >> __aeabi_memcpy

[Address Reference Count : 1]

- sd_diskio.o(.data)

SD_status (Thumb, 26 bytes, Stack size 8 bytes, sd_diskio.o(i.SD_status))

[Stack]

- Max Depth = 72
- Call Chain = SD_status ⇒ BSP_SD_GetStatus ⇒ HAL_SD_GetStatus ⇒ SD_CmdResp1Error ⇒ SDIO_GetResponse

[Calls]

- >> BSP_SD_GetStatus

[Address Reference Count : 1]

- sd_diskio.o(.data)

SD_write (Thumb, 132 bytes, Stack size 552 bytes, sd_diskio.o(i.SD_write))

[Stack]

- Max Depth = 688
- Call Chain = SD_write ⇒ BSP_SD_WriteBlocks_DMA ⇒ HAL_SD_WriteBlocks_DMA ⇒ HAL_DMA_Start_IT ⇒ DMA_SetConfig

[Calls]

- >> BSP_SD_WriteBlocks_DMA
- >> BSP_SD_GetStatus
- >> __aeabi_memcpy

[Address Reference Count : 1]

- sd_diskio.o(.data)

SysTick_Handler (Thumb, 14 bytes, Stack size 8 bytes, stm32f2xx_it.o(i.SysTick_Handler))

[Stack]

- Max Depth = 16
- Call Chain = SysTick_Handler ⇒ HAL_SYSTICK_IRQHandler

[Calls]

- >> HAL_SYSTICK_IRQHandler
- >> HAL_IncTick

[Address Reference Count : 1]

- startup_stm32f207xx.o(RESET)

SystemClock_Config (Thumb, 84 bytes, Stack size 104 bytes, main.o(i.SystemClock_Config))

[Stack]

- Max Depth = 152
- Call Chain = SystemClock_Config ⇒ HAL_RCC_ClockConfig ⇒ HAL_RCC_GetHCLKFreq ⇒ HAL_RCC_GetSysClockFreq

[Calls]

- >> HAL_RCC_OscConfig
- >> HAL_RCC_ClockConfig
- >> HAL_RCCEx_PeriphCLKConfig

[Called By]

- >> main

SystemInit (Thumb, 54 bytes, Stack size 0 bytes, system_stm32f2xx.o(i.SystemInit))
[Address Reference Count : 1]

- startup_stm32f207xx.o(.text)

TIM_Base_SetConfig (Thumb, 148 bytes, Stack size 20 bytes, stm32f2xx_hal_tim.o(i.TIM_Base_SetConfig))

[Stack]

- Max Depth = 20
- Call Chain = TIM_Base_SetConfig

[Called By]

- >> HAL_TIM_OnePulse_Init
- >> HAL_TIM_IC_Init
- >> HAL_TIM_Base_Init

TIM_TI1_SetConfig (Thumb, 98 bytes, Stack size 16 bytes, stm32f2xx_hal_tim.o(i.TIM_TI1_SetConfig))

[Stack]

- Max Depth = 16
- Call Chain = TIM_TI1_SetConfig

[Called By]

- >> HAL_TIM_IC_ConfigChannel

__scatterload_copy (Thumb, 14 bytes, Stack size unknown bytes, handlers.o(i.__scatterload_copy), UNUSED)

__scatterload_null (Thumb, 2 bytes, Stack size unknown bytes, handlers.o(i.__scatterload_null), UNUSED)

__scatterload_zeroinit (Thumb, 14 bytes, Stack size unknown bytes, handlers.o(i.__scatterload_zeroinit), UNUSED)

assert_failed (Thumb, 2 bytes, Stack size 0 bytes, main.o(i.assert_failed))

[Called By]

- >> HAL_IWDG_Init
- >> HAL_DMA_Start_IT
- >> HAL_ADC_Start
- >> HAL_ADC_Init
- >> HAL_ADC_ConfigChannel
- >> ADC_Init
- >> HAL_WWDG_Init
- >> HAL_GPIO_Init
- >> HAL_RCC_OscConfig
- >> HAL_RCC_ClockConfig
- >> HAL_NVIC_SetPriorityGrouping
- >> HAL_NVIC_SetPriority
- >> HAL_SPI_Init
- >> HAL_DMA_Init
- >> HAL_TIMEx_MasterConfigSynchronization
- >> HAL_I2C_Init
- >> HAL_GPIO_WritePin
- >> HAL_RTC_SetTime
- >> HAL_RTC_SetDate
- >> HAL_RTC_SetAlarm_IT
- >> HAL_RTC_Init
- >> SDIO_SendCommand
- >> SDIO_Init
- >> SDIO_GetResponse
- >> SDIO_DataConfig
- >> HAL_RCCEx_PeriphCLKConfig
- >> HAL_TIM_SlaveConfigSynchronization
- >> HAL_TIM_OnePulse_Init
- >> HAL_TIM_IC_Init
- >> HAL_TIM_IC_ConfigChannel
- >> HAL_TIM_Base_Init

main (Thumb, 328 bytes, Stack size 40 bytes, main.o(i.main))

[Stack]

- Max Depth = 192
- Call Chain = main ⇒ SystemClock_Config ⇒ HAL_RCC_ClockConfig ⇒ HAL_RCC_GetHCLKFreq ⇒ HAL_RCC_GetSysClockFreq

[Calls]

- >> FATFS_LinkDriver
- >> HAL_ADC_Start
- >> HAL_ADC_PollForConversion
- >> HAL_ADC_Init
- >> HAL_ADC_GetValue
- >> HAL_ADC_ConfigChannel
- >> HAL_GPIO_Init
- >> HAL_GPIO_WritePin
- >> HAL_Init
- >> HAL_ADC_MspInit
- >> MX_WWDG_Init
- >> MX_SPI1_Init
- >> MX_ADC3_Init
- >> MX_ADC2_Init
- >> MX_ADC1_Init
- >> SystemClock_Config
- >> MX_IWDG_Init
- >> MX_USB_OTG_FS_USB_Init
- >> MX_SDIO_SD_Init
- >> MX_RTC_Init
- >> MX_GPIO_Init
- >> MX_DMA_Init
- >> MX_TIM1_Init
- >> MX_I2C3_Init
- >> MX_I2C2_Init

[Address Reference Count : 1]

- entry9a.o(.ARM.Collect$$$$0000000B)

### Local Symbols

ADC_Init (Thumb, 296 bytes, Stack size 8 bytes, stm32f2xx_hal_adc.o(i.ADC_Init))

[Stack]

- Max Depth = 8
- Call Chain = ADC_Init

[Calls]

- >> assert_failed

[Called By]

- >> HAL_ADC_Init

DMA_SetConfig (Thumb, 30 bytes, Stack size 8 bytes, stm32f2xx_hal_dma.o(i.DMA_SetConfig))

[Stack]

- Max Depth = 8
- Call Chain = DMA_SetConfig

[Called By]

- >> HAL_DMA_Start_IT

NVIC_SetPriority (Thumb, 32 bytes, Stack size 0 bytes, stm32f2xx_hal_cortex.o(i.NVIC_SetPriority))

[Called By]

- >> HAL_SYSTICK_Config
- >> HAL_NVIC_SetPriority

SD_CmdResp1Error (Thumb, 230 bytes, Stack size 16 bytes, stm32f2xx_hal_sd.o(i.SD_CmdResp1Error))

[Stack]

- Max Depth = 32
- Call Chain = SD_CmdResp1Error ⇒ SDIO_GetResponse

[Calls]

- >> SDIO_GetResponse
- >> SDIO_GetCommandResponse

[Called By]

- >> HAL_SD_WriteBlocks_DMA
- >> HAL_SD_StopTransfer
- >> HAL_SD_SendSDStatus
- >> HAL_SD_ReadBlocks_DMA
- >> HAL_SD_Init
- >> HAL_SD_GetStatus
- >> SD_WideBus_Enable
- >> SD_WideBus_Disable
- >> SD_PowerON
- >> SD_FindSCR

SD_CmdResp2Error (Thumb, 46 bytes, Stack size 0 bytes, stm32f2xx_hal_sd.o(i.SD_CmdResp2Error))

[Called By]

- >> SD_Initialize_Cards

SD_CmdResp6Error (Thumb, 114 bytes, Stack size 24 bytes, stm32f2xx_hal_sd.o(i.SD_CmdResp6Error))

[Stack]

- Max Depth = 40
- Call Chain = SD_CmdResp6Error ⇒ SDIO_GetResponse

[Calls]

- >> SDIO_GetResponse
- >> SDIO_GetCommandResponse

[Called By]

- >> SD_Initialize_Cards

SD_CmdResp7Error (Thumb, 64 bytes, Stack size 0 bytes, stm32f2xx_hal_sd.o(i.SD_CmdResp7Error))

[Called By]

- >> SD_PowerON

SD_DMA_RxCplt (Thumb, 22 bytes, Stack size 8 bytes, stm32f2xx_hal_sd.o(i.SD_DMA_RxCplt))

[Stack]

- Max Depth = 8
- Call Chain = SD_DMA_RxCplt

[Calls]

- >> HAL_SD_DMA_RxCpltCallback

[Address Reference Count : 1]

- stm32f2xx_hal_sd.o(i.HAL_SD_ReadBlocks_DMA)

SD_DMA_RxError (Thumb, 12 bytes, Stack size 8 bytes, stm32f2xx_hal_sd.o(i.SD_DMA_RxError))

[Stack]

- Max Depth = 8
- Call Chain = SD_DMA_RxError

[Calls]

- >> HAL_SD_DMA_RxErrorCallback

[Address Reference Count : 1]

- stm32f2xx_hal_sd.o(i.HAL_SD_ReadBlocks_DMA)

SD_DMA_TxCplt (Thumb, 22 bytes, Stack size 8 bytes, stm32f2xx_hal_sd.o(i.SD_DMA_TxCplt))

[Stack]

- Max Depth = 8
- Call Chain = SD_DMA_TxCplt

[Calls]

- >> HAL_SD_DMA_TxCpltCallback

[Address Reference Count : 1]

- stm32f2xx_hal_sd.o(i.HAL_SD_WriteBlocks_DMA)

SD_DMA_TxError (Thumb, 12 bytes, Stack size 8 bytes, stm32f2xx_hal_sd.o(i.SD_DMA_TxError))

[Stack]

- Max Depth = 8
- Call Chain = SD_DMA_TxError

[Calls]

- >> HAL_SD_DMA_TxErrorCallback

[Address Reference Count : 1]

- stm32f2xx_hal_sd.o(i.HAL_SD_WriteBlocks_DMA)

SD_FindSCR (Thumb, 266 bytes, Stack size 104 bytes, stm32f2xx_hal_sd.o(i.SD_FindSCR))

[Stack]

- Max Depth = 136
- Call Chain = SD_FindSCR ⇒ SD_CmdResp1Error ⇒ SDIO_GetResponse

[Calls]

- >> SD_CmdResp1Error
- >> SDIO_SendCommand
- >> SDIO_ReadFIFO
- >> SDIO_DataConfig

[Called By]

- >> SD_WideBus_Enable
- >> SD_WideBus_Disable

SD_Initialize_Cards (Thumb, 220 bytes, Stack size 40 bytes, stm32f2xx_hal_sd.o(i.SD_Initialize_Cards))

[Stack]

- Max Depth = 80
- Call Chain = SD_Initialize_Cards ⇒ SD_CmdResp6Error ⇒ SDIO_GetResponse

[Calls]

- >> SD_CmdResp6Error
- >> SD_CmdResp2Error
- >> SDIO_SendCommand
- >> SDIO_GetResponse
- >> SDIO_GetPowerState

[Called By]

- >> HAL_SD_Init

SD_PowerON (Thumb, 360 bytes, Stack size 64 bytes, stm32f2xx_hal_sd.o(i.SD_PowerON))

[Stack]

- Max Depth = 96
- Call Chain = SD_PowerON ⇒ SD_CmdResp1Error ⇒ SDIO_GetResponse

[Calls]

- >> SD_CmdResp7Error
- >> SD_CmdResp1Error
- >> SDIO_SendCommand
- >> SDIO_PowerState_ON
- >> SDIO_GetResponse

[Called By]

- >> HAL_SD_Init

SD_WideBus_Disable (Thumb, 114 bytes, Stack size 48 bytes, stm32f2xx_hal_sd.o(i.SD_WideBus_Disable))

[Stack]

- Max Depth = 184
- Call Chain = SD_WideBus_Disable ⇒ SD_FindSCR ⇒ SD_CmdResp1Error ⇒ SDIO_GetResponse

[Calls]

- >> SD_FindSCR
- >> SD_CmdResp1Error
- >> SDIO_SendCommand
- >> SDIO_GetResponse

[Called By]

- >> HAL_SD_WideBusOperation_Config

SD_WideBus_Enable (Thumb, 116 bytes, Stack size 48 bytes, stm32f2xx_hal_sd.o(i.SD_WideBus_Enable))

[Stack]

- Max Depth = 184
- Call Chain = SD_WideBus_Enable ⇒ SD_FindSCR ⇒ SD_CmdResp1Error ⇒ SDIO_GetResponse

[Calls]

- >> SD_FindSCR
- >> SD_CmdResp1Error
- >> SDIO_SendCommand
- >> SDIO_GetResponse

[Called By]

- >> HAL_SD_WideBusOperation_Config

TIM_ETR_SetConfig (Thumb, 20 bytes, Stack size 8 bytes, stm32f2xx_hal_tim.o(i.TIM_ETR_SetConfig))

[Stack]

- Max Depth = 8
- Call Chain = TIM_ETR_SetConfig

[Called By]

- >> HAL_TIM_SlaveConfigSynchronization

TIM_TI1_ConfigInputStage (Thumb, 34 bytes, Stack size 8 bytes, stm32f2xx_hal_tim.o(i.TIM_TI1_ConfigInputStage))

[Stack]

- Max Depth = 8
- Call Chain = TIM_TI1_ConfigInputStage

[Called By]

- >> HAL_TIM_SlaveConfigSynchronization

TIM_TI2_ConfigInputStage (Thumb, 36 bytes, Stack size 8 bytes, stm32f2xx_hal_tim.o(i.TIM_TI2_ConfigInputStage))

[Stack]

- Max Depth = 8
- Call Chain = TIM_TI2_ConfigInputStage

[Called By]

- >> HAL_TIM_SlaveConfigSynchronization

TIM_TI2_SetConfig (Thumb, 44 bytes, Stack size 12 bytes, stm32f2xx_hal_tim.o(i.TIM_TI2_SetConfig))

[Stack]

- Max Depth = 12
- Call Chain = TIM_TI2_SetConfig

[Called By]

- >> HAL_TIM_IC_ConfigChannel

### Undefined Global Symbols
