erebus-labs/sense_platform/Design/VOC_SensorBoard.brd

## EAGLE design Design/VOC_SensorBoard.brd (2015-06-09)

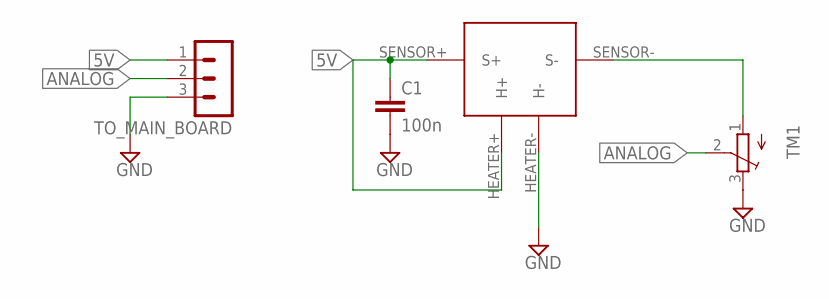
[picture p22: schematic VOC_SensorBoard.sch]

Parts:
C1: 100n; C0805
TM1: TRIMPOTTC33X; TC33X
TO_MAIN_BOARD: MA03-1
U$1: TGS2602

Connections:
5V: C1.1, TO_MAIN_BOARD.1, U$1.HEATER+ (H+), U$1.SENSOR+ (S+)
ANALOG: TM1.2 (S), TO_MAIN_BOARD.2
GND: C1.2, TM1.3 (E), TO_MAIN_BOARD.3, U$1.HEATER- (H-)
unnamed: TM1.1 (A), U$1.SENSOR- (S-)

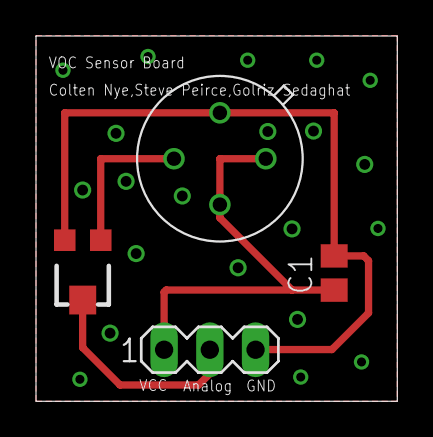
[picture p23: board VOC_SensorBoard.brd from above]

Board: 2 copper layers, 20.1 x 20.3 mm, 4 parts (0 on the bottom side), 4 nets.
