erebus-labs/sense_platform/Design/ACC_SensorBoard.brd

## EAGLE design Design/ACC_SensorBoard.brd (2015-06-09)

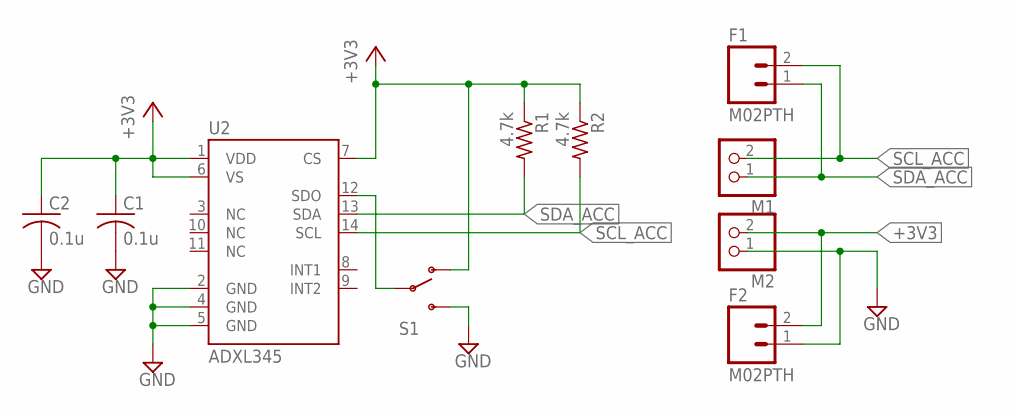
[picture p24: schematic ACC_SensorBoard.sch]

Parts:
C1, C2: 0.1u; C0805
F1, F2: M02PTH; 1X02
M1, M2: PINHD-1X2; 1X02
R1, R2: 4.7k; R0805
S1: SWITCH-SPDTSMD; AYZ0202
U2: ADXL345; LGA14

Connections:
+3V3: C1.1, C2.1, F2.2, M2.2, R1.1, R2.1, S1.1 (O), U2.1 (VDD), U2.6 (VS), U2.7 (CS)
GND: C1.2, C2.2, F2.1, M2.1, S1.3 (S), U2.2 (GND), U2.4 (GND), U2.5 (GND)
unnamed: S1.2, U2.12 (SDO)
SCL_ACC: F1.2, M1.2, R2.2, U2.14 (SCL)
SDA_ACC: F1.1, M1.1, R1.2, U2.13 (SDA)

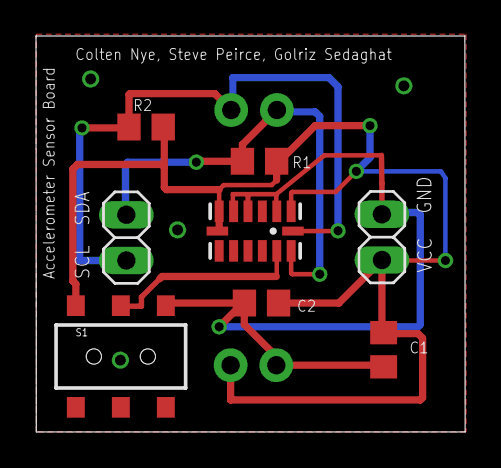
[picture p25: board ACC_SensorBoard.brd from above]

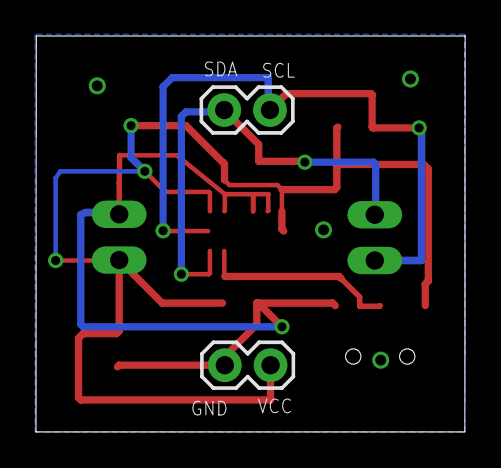
[picture p26: board ACC_SensorBoard.brd from below]

Board: 2 copper layers, 23.8 x 22.0 mm, 10 parts (2 on the bottom side), 5 nets.
