erebus-labs/sense_platform/Design/MainBoardV2.brd

## EAGLE design Design/MainBoardV2.brd (2015-06-09)

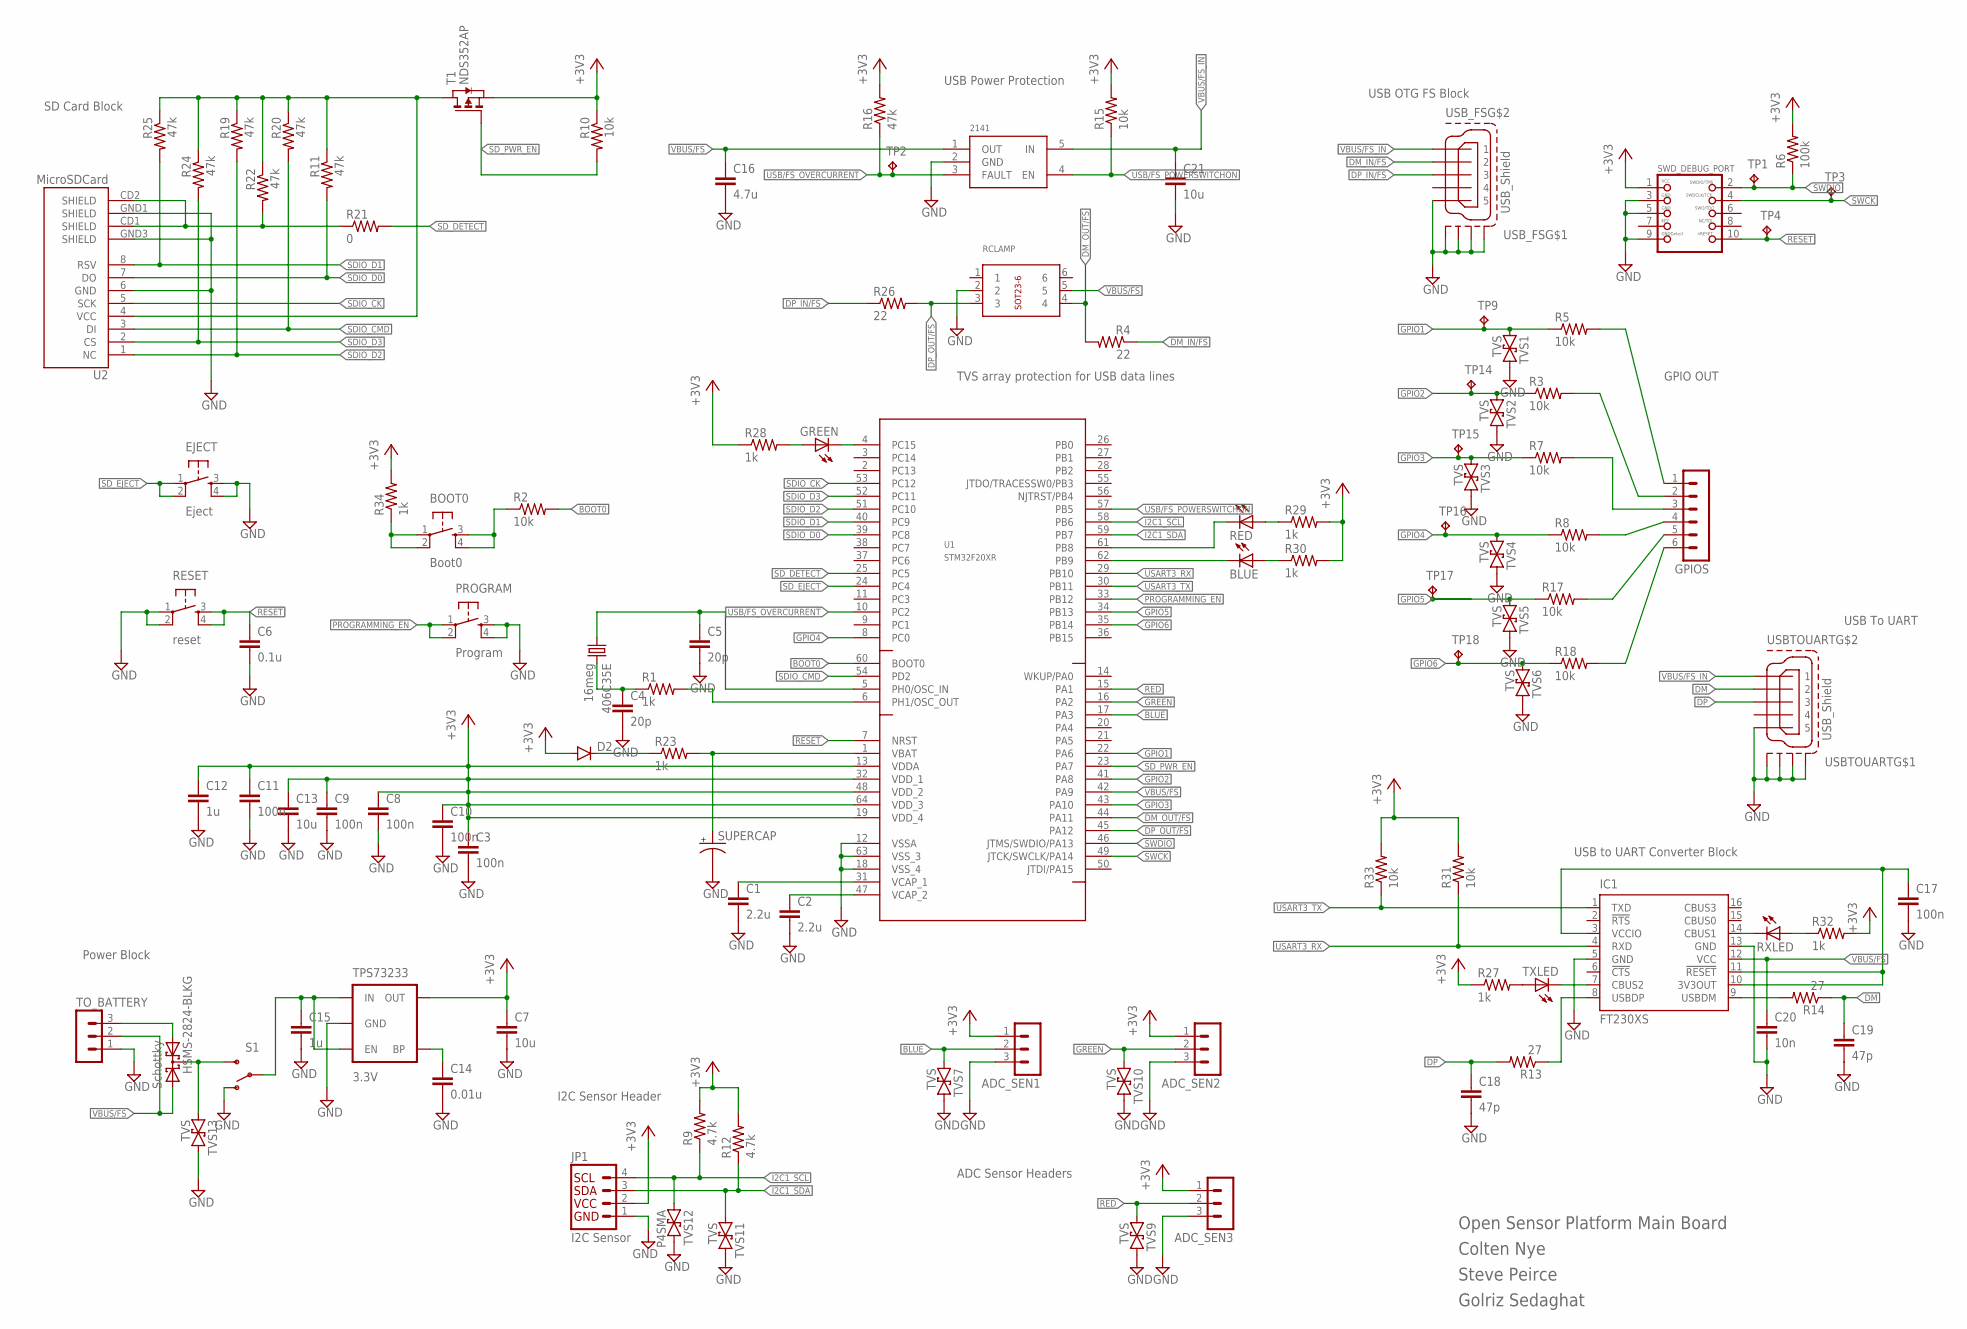
[picture p27: schematic MainBoardV2.sch]

Parts:
406C35E: 16meg; CTS406
2141: NCP1400A_STEPUP; SOT23-5
ADC_SEN1, ADC_SEN2, ADC_SEN3: MA03-1
BLUE: LEDSML0805; SML0805
BOOT0: Boot0; TACTILE-SWITCH-SMD
C1, C2: 2.2u; C0805
C3, C8, C9, C10, C11, C17: 100n; C0805
C4, C5: 20p; C0805
C6: 0.1u; C0805
C7, C13, C21: 10u; C0805
C12, C15: 1u; C0805
C14: 0.01u; C0805
C16: 4.7u; C0805
C18, C19: 47p; C0805
C20: 10n; C0805
D2: DIODESMA; SMA-DIODE
EJECT: Eject; TACTILE-SWITCH-SMD
GPIOS: MA06-1
GREEN: LEDSML0805; SML0805
HSMS-2824-BLKG: Schottky; SOT23
IC1: FT230XS; SSOP16
JP1: I2C Sensor; 1X04
PROGRAM: Program; TACTILE-SWITCH-SMD
R1, R23, R27, R28, R29, R30, R32, R34: 1k; R0805
R2, R3, R5, R7, R8, R10, R15, R17, R18, R31, R33: 10k; R0805
R4, R26: 22; R0805
R6: 100k; R0805
R9, R12: 4.7k; R0805
R11, R16, R19, R20, R22, R24, R25: 47k; R0805
R13, R14: 27; R0805
R21: 0; R0805
RCLAMP: BREAKOUT_SOT23-6
RED: LEDSML0805; SML0805
RESET: reset; TACTILE-SWITCH-SMD
RXLED: LEDSML0805; SML0805
S1: SWITCH-SPDTSMD; AYZ0202
SUPERCAP: SUPERCAP; 414-VA5R
SWD_DEBUG_PORT: JTAG-CORTEXM3; 2X05_1.27MM_SMT
T1: NDS352AP; SOT-23
TO_BATTERY: MA03-1
TP1, TP2, TP3, TP4, TP9, TP14, TP15, TP16, TP17, TP18: TPB1,27; B1,27
TPS73233: 3.3V; SOT23-5
TVS1, TVS2, TVS3, TVS4, TVS5, TVS6, TVS7, TVS9, TVS10, TVS11, TVS13: TVS; SMA-DIODE
TVS12: P4SMA; SMA-DIODE
TXLED: LEDSML0805; SML0805
U1: STM32F20XR; LQFP64
U2: MicroSDCard; MICRO-SD-SOCKET-PP
USBTOUART: USB_Shield; ZX62R-B-5P
USB_FS: USB_Shield; ZX62R-B-5P

Connections:
+3V3: ADC_SEN1.1, ADC_SEN2.1, ADC_SEN3.1, C3.1, C7.1, C8.1, C9.1, C10.1, C11.1, C12.1, C13.1, D2.A, JP1.2, R6.2, R9.2, R10.1, R12.2, R15.2, R16.2, R27.1, R28.1, R29.2, R30.2, R31.2, R32.2, R33.2, R34.2, SWD_DEBUG_PORT.1, T1.2 (S), TPS73233.5 (OUT), U1.13 (VDDA), U1.19 (VDD_4), U1.32 (VDD_1), U1.48 (VDD_2), U1.64 (VDD_3)
BLUE: ADC_SEN1.2, TVS7.A (1), U1.17 (PA3)
BOOT0: R2.2, U1.60 (BOOT0)
DEBUG_LED/NP1: GPIOS.1, R5.2
DEBUG_LED/NP2: GPIOS.2, R3.2
DEBUG_LED/NP3: GPIOS.3, R7.2
DEBUG_LED/NP4: GPIOS.4, R8.2
DEBUG_LED/NP5: GPIOS.5, R17.2
DEBUG_LED/NP6: GPIOS.6, R18.2
DM: C19.1, R14.1, USBTOUART.2
DM_IN/FS: R4.1, USB_FS.2
DM_OUT/FS: R4.2, RCLAMP.4, U1.44 (PA11)
DP: C18.1, R13.2, USBTOUART.3
DP_IN/FS: R26.1, USB_FS.3
DP_OUT/FS: R26.2, RCLAMP.3, U1.45 (PA12)
GND: 2141.2 (GND), ADC_SEN1.3, ADC_SEN2.3, ADC_SEN3.3, C1.2, C2.2, C3.2, C4.2, C5.2, C6.2, C7.2, C8.2, C9.2, C10.2, C11.2, C12.2, C13.2, C14.2, C15.2, C16.2, C17.2, C18.2, C19.2, C20.2, C21.2, EJECT.3, EJECT.4, IC1.5 (GND), IC1.13 (GND), JP1.1, PROGRAM.3, PROGRAM.4, RCLAMP.2, RESET.1, RESET.2, S1.1 (O), SUPERCAP.-, SWD_DEBUG_PORT.3, SWD_DEBUG_PORT.5, SWD_DEBUG_PORT.9, TO_BATTERY.1, TPS73233.2 (GND), TVS1.C (2), TVS2.C (2), TVS3.C (2), TVS4.C (2), TVS5.C (2), TVS6.C (2), TVS7.C (2), TVS9.C (2), TVS10.C (2), TVS11.C (2), TVS12.C (2), TVS13.C (2), U1.12 (VSSA), U1.18 (VSS_4), U1.63 (VSS_3), U2.6 (GND), U2.GND1 (SHIELD), U2.GND3 (SHIELD), USBTOUART.5, USBTOUART.M1 (S1), USBTOUART.M2 (S2), USBTOUART.M3 (S3), USBTOUART.M4 (S4), USB_FS.5, USB_FS.M1 (S1), USB_FS.M2 (S2), USB_FS.M3 (S3), USB_FS.M4 (S4)
GPIO1: R5.1, TP9.TP, TVS1.A (1), U1.22 (PA6)
GPIO2: R3.1, TP14.TP, TVS2.A (1), U1.41 (PA8)
GPIO3: R7.1, TP15.TP, TVS3.A (1), U1.43 (PA10)
GPIO4: R8.1, TP16.TP, TVS4.A (1), U1.8 (PC0)
GPIO5: R17.1, TP17.TP, TVS5.A (1), U1.34 (PB13)
GPIO6: R18.1, TP18.TP, TVS6.A (1), U1.35 (PB14)
GREEN: ADC_SEN2.2, TVS10.A (1), U1.16 (PA2)
I2C1_SCL: JP1.4, R9.1, TVS12.A (1), U1.58 (PB6)
I2C1_SDA: JP1.3, R12.1, TVS11.A (1), U1.59 (PB7)
unnamed: C1.1, U1.31 (VCAP_1)
unnamed: C2.1, U1.47 (VCAP_2)
unnamed: GREEN.C, U1.4 (PC15)
unnamed: HSMS-2824-BLKG.1 (A1), TO_BATTERY.3
unnamed: 406C35E.3 (2), C4.1, R1.1
unnamed: BOOT0.3, BOOT0.4, R2.1
unnamed: C17.1, IC1.3 (VCCIO), IC1.10 (3V3OUT), IC1.11 (!RESET)
unnamed: IC1.9 (USBDM), R14.2
unnamed: IC1.8 (USBDP), R13.1
unnamed: C14.1, TPS73233.4 (BP)
unnamed: BOOT0.1, BOOT0.2, R34.1
unnamed: R27.2, TXLED.A
unnamed: BLUE.C, U1.62 (PB9)
unnamed: R21.1, R22.2, U2.CD1 (SHIELD), U2.CD2 (SHIELD)
unnamed: D2.C, R23.1
unnamed: R29.1, RED.A
unnamed: GREEN.A, R28.2
unnamed: BLUE.A, R30.1
unnamed: R32.1, RXLED.A
unnamed: RED.C, U1.61 (PB8)
unnamed: HSMS-2824-BLKG.3 (C), S1.3 (S), TVS13.A (1)
unnamed: IC1.14 (CBUS1), RXLED.C
unnamed: IC1.7 (CBUS2), TXLED.C
unnamed: R11.1, R19.1, R20.1, R22.1, R24.1, R25.1, T1.1 (D), U2.4 (VCC)
OSC_IN: 406C35E.1, C5.1, U1.5 (PH0/OSC_IN)
OSC_OUT: R1.2, U1.6 (PH1/OSC_OUT)
PROGRAMMING_EN: PROGRAM.1, PROGRAM.2, U1.33 (PB12)
RED: ADC_SEN3.2, TVS9.A (1), U1.15 (PA1)
RESET: C6.1, RESET.3, RESET.4, SWD_DEBUG_PORT.10, TP4.TP, U1.7 (NRST)
SDIO_CK: U1.53 (PC12), U2.5 (SCK)
SDIO_CMD: R20.2, U1.54 (PD2), U2.3 (DI)
SDIO_D0: R11.2, U1.39 (PC8), U2.7 (DO)
SDIO_D1: R25.2, U1.40 (PC9), U2.8 (RSV)
SDIO_D2: R19.2, U1.51 (PC10), U2.1 (NC)
SDIO_D3: R24.2, U1.52 (PC11), U2.2 (CS)
SD_DETECT: R21.2, U1.25 (PC5)
SD_EJECT: EJECT.1, EJECT.2, U1.24 (PC4)
SD_PWR_EN: R10.2, T1.3 (G), U1.23 (PA7)
SWCK: SWD_DEBUG_PORT.4, TP3.TP, U1.49 (JTCK/SWCLK/PA14)
SWDIO: R6.1, SWD_DEBUG_PORT.2, TP1.TP, U1.46 (JTMS/SWDIO/PA13)
USART3_RX: IC1.4 (RXD), R31.1, U1.29 (PB10)
USART3_TX: IC1.1 (TXD), R33.1, U1.30 (PB11)
USB/FS_OVERCURRENT: 2141.3 (FAULT), R16.1, TP2.TP, U1.10 (PC2)
USB/FS_POWERSWITCHON: 2141.4 (EN), R15.1, U1.57 (PB5)
VBAT: R23.2, SUPERCAP.+, U1.1 (VBAT)
VBUS/FS: 2141.1 (OUT), C16.1, C20.1, HSMS-2824-BLKG.2 (A2), IC1.12 (VCC), RCLAMP.5, TO_BATTERY.2, U1.42 (PA9)
VBUS/FS_IN: 2141.5 (IN), C21.1, USBTOUART.1, USB_FS.1
VIN: C15.1, S1.2, TPS73233.1 (IN), TPS73233.3 (EN)

Notes on the sheet:
Colten Nye
USB OTG FS Block
I2C Sensor Header
ADC Sensor Headers
SD Card Block
Power Block
Steve Peirce
Golriz Sedaghat
Open Sensor Platform Main Board
GPIO OUT
USB to UART Converter Block
USB Power Protection
TVS array protection for USB data lines
USB To UART

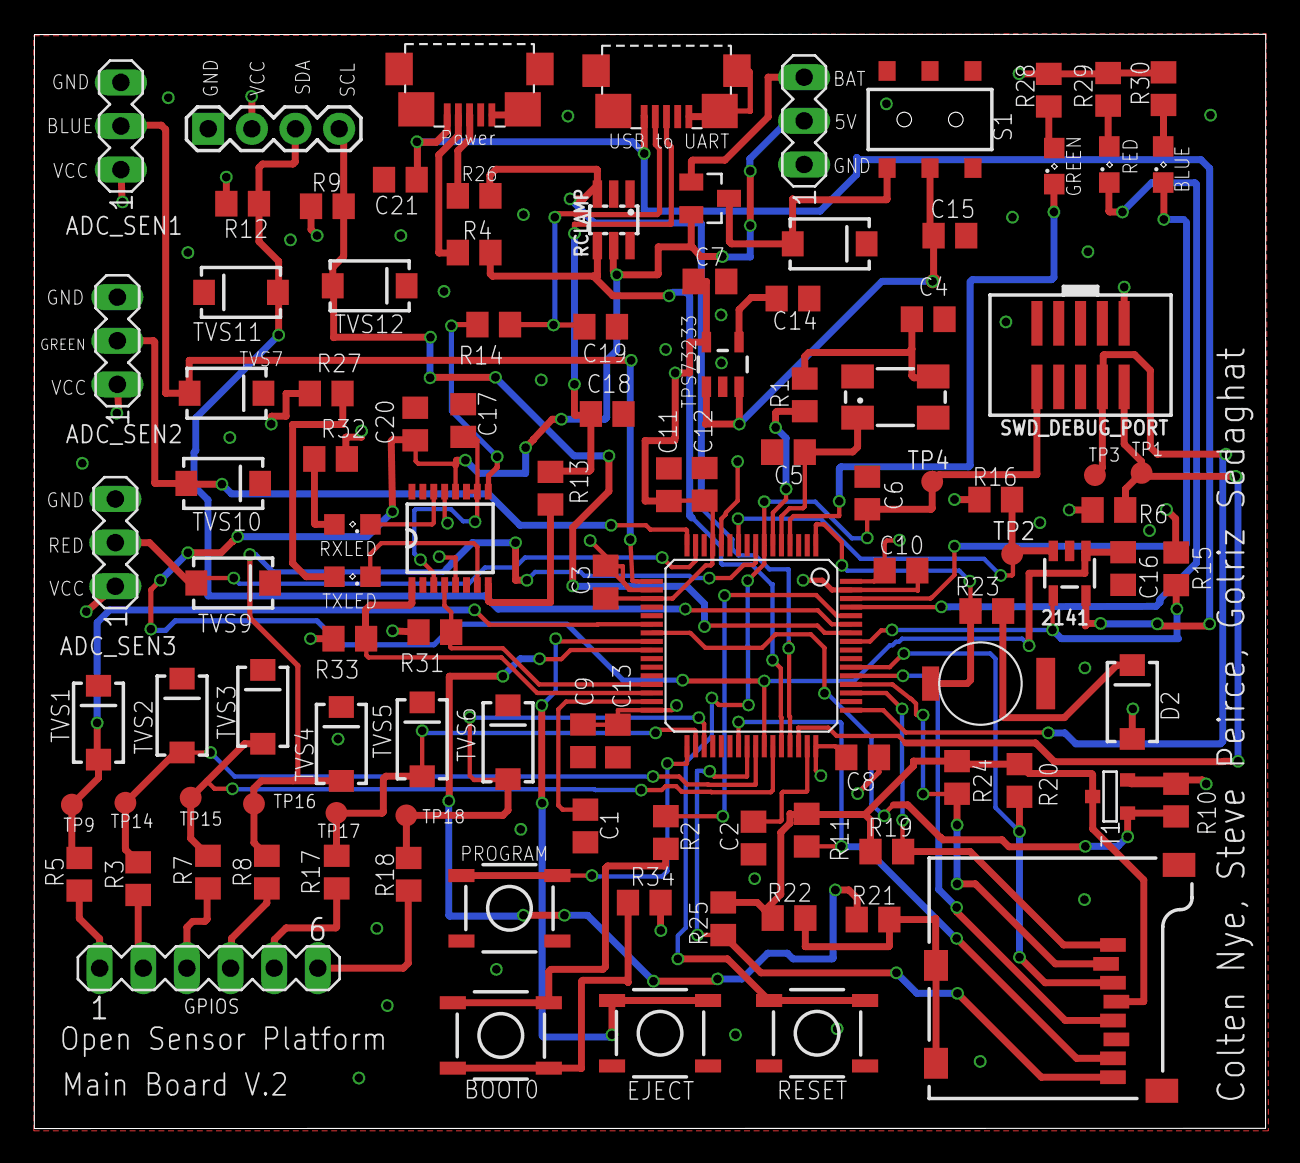
[picture p28: board MainBoardV2.brd from above]

Board: 4 copper layers, 71.7 x 63.7 mm, 107 parts (0 on the bottom side), 73 nets.
