erebus-labs/sense_platform/Config Protocol/pass config protocol.txt

time, overwrite, numsensors
sensor
	name, type, address, a, b, c, settle time, init, read

* begin *
