erebus-labs/sense_platform/(commit log)

2015-01-10 Documentation for the STM32F207VCT6
2015-02-21 Flowchart diagrams for programming the devicee
2015-02-23 Test Plan
    [Test Plan.xlsx]
2015-02-24 D Makefile for STM32 using STMCube LHAL Libraries.
2015-02-24 prop outline
2015-02-24 Small Corrections
    [BOM.xlsx, main_board_sch.sch]
2015-02-24 D D Receipt for Dev board from DigilKey
2015-02-24 raw code test, GPIOE
    [commands.cfg]
2015-02-24 CAPSTONE Test Program v3 from STMCubeMX, ALL Libraries needed
    [commands.cfg]
2015-02-24 Header files for STM32f205/7
2015-02-25 Documents for eval board
2015-02-26 current code for new eval board w all libs
    [commands.cfg]
2015-02-27 Notes from proposal
    [BOM.xlsx]
2015-02-28 Schematic Update
    [MainBoard_V1.0.sch, MainBoard_V1.1.sch, PinList_V1.0.xlsx]
2015-02-28 Document Revision
    [BOM.xlsx, MainBoard_V1.1.sch]
2015-03-01 Revert "Document Revision"
    This reverts commit 87a539b43a6471277175cce403c1623fabaade23.
    [BOM.xlsx, MainBoard_V1.1.sch]
2015-03-03 Proposal update
    [BOM.xlsx, MainBoard_V1.1.sch]
2015-03-18 Design Updates
    [ACC_SensorBoard.brd, ACC_SensorBoard.sch, MainBoard_V1.3.brd, MainBoard_V1.3.sch, PinList_V1.0.xlsx, PinList_V1.1.xlsx, VOC_SensorBoard.brd, VOC_SensorBoard.sch]
2015-03-19 Updated schematics and boards
    [ACC_SensorBoard.brd, ACC_SensorBoard.sch, MainBoard_V1.3.brd, MainBoard_V1.3.sch]
2015-03-19 Updates
    - Main board diagram was revised
    - Proposal document was completed
    - Project schedule was revised
    [main_board_sch.sch]
2015-03-19 Pin list update
    [PinList_V1.1.xlsx]
2015-03-20 FIRMWARE BACKUPS
    backup of accelerometer header
2015-03-22 Design Final Revision
    [ACC_SensorBoard.brd, ACC_SensorBoard.sch, MainBoard.brd, MainBoard.sch, VOC_SensorBoard.brd]
2015-03-23 VOC was taken off from the BOM
    [BOM.xlsx]
2015-03-24 Slight changes
    [BOM.xlsx]
2015-03-29 Restructure Docs dir, Add GUI compare table
    renamed "Project Flow Docs" to simply "Documents"
    removed "Project Documents" Subdirectory
    Added "Meeting Notes" directory
    Added GUI platform comparison table
    [BOM.xlsx, GUI platform selection criteria.xlsx, Test Plan.xlsx]
2015-04-15 Create main_41515.c
    Curent version being worked on, still based on STM207 until all systems are live. MISSING: USART RX and SDIO functions
    [main_41515.c]
2015-04-16 Current working version
2015-04-16 Current working version. Needs SDIO and continuing work on USART RX. Serial will program timers and fill sensor struct
2015-04-16 Updated error on USART RX IRQ callback routine
    [main_41515.c]
2015-04-17 Work on config parsing
    [BOM.xlsx, pass config protocol.txt, serialParser.sdf]
2015-04-17 Revised Test Plan
    [Test PlanV.2.0.xlsx]
2015-04-17 Changed the location
    [Test PlanV.2.0.xlsx]
2015-04-20 Updated Pin List
    [PinList_V1.1.xlsx]
2015-04-27 2nd Version of Board and Schematic
    [MainBoardV1.brd, MainBoardV1.sch, MainBoardV2.brd, MainBoardV2.sch, MainBoard_V1.3.brd]
2015-04-30 Modified revision of board and schematic
    [MainBoardV2.brd, MainBoardV2.sch]
2015-05-07 Serial Protocol
    look in .\Config Protocol\serialParser\serialParser\SerialParser.cpp
    [serialParser.sdf]
2015-05-07 Added I2C config, ADC config, etc.
2015-05-21 Updated Pinlist
    [PinList_V1.1.xlsx]
2015-06-09 Updating/Cleaning-up documents
    [ACC_SensorBoard.brd, ACC_SensorBoard.sch, BOM.xlsx, MainBoardV1.brd, MainBoardV1.sch, MainBoardV2.brd, MainBoardV2.sch, Test Plan.xlsx]
